moritzwerkeat/sdr-sch/74HC541D/74HC541D.stp

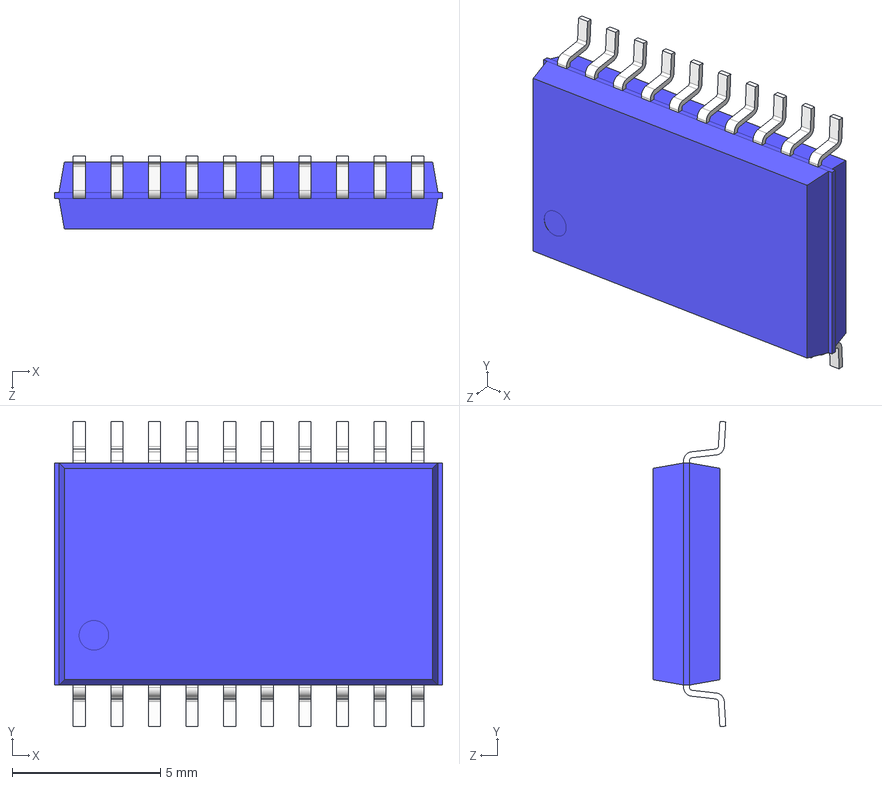
[picture p1: CAD file, 2024-10-22]
74HC541D/74HC541D.stp
13.1 x 10.3 x 2.45 mm
