moritzwerkeat/sdr-sch/74LVC04AD-Q100J/74LVC04AD-Q100J.stp

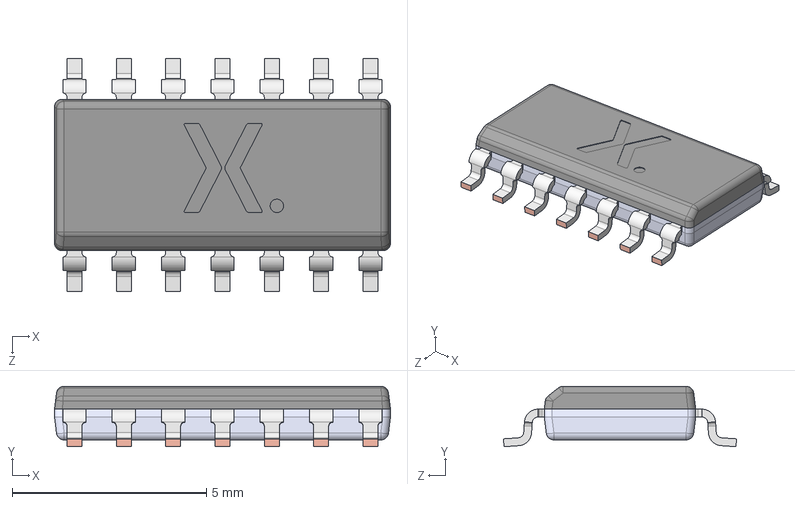
[picture p2: CAD file, 2024-10-22]
74LVC04AD-Q100J/74LVC04AD-Q100J.stp
8.65 x 1.56 x 6.00 mm
SOT108 lower body
SOT108 upper body
SOT108-1 Lead
