moritzwerkeat/sdr-sch/AP3032KTR-G1/AP3032KTR-G1.stp

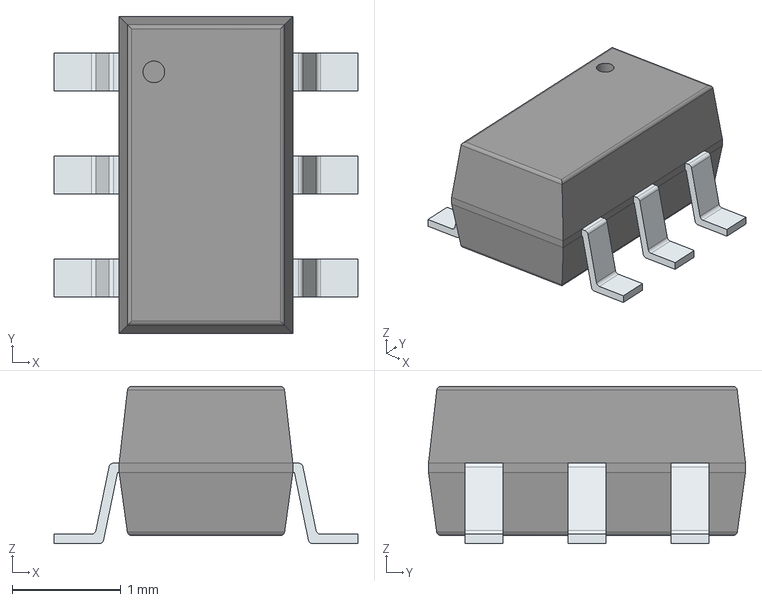
[picture p3: CAD file, 2024-10-22]
AP3032KTR-G1/AP3032KTR-G1.stp
2.80 x 2.92 x 1.45 mm
PinsArrayLR
