moritzwerkeat/sdr-sch/B5819WS/B5819WS.stp

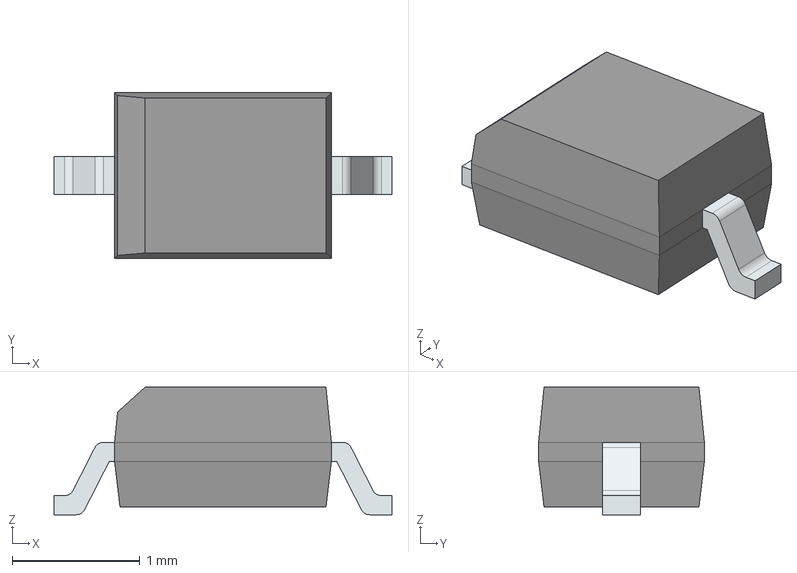
[picture p4: CAD file, 2024-10-22]
B5819WS/B5819WS.stp
2.65 x 1.30 x 1.00 mm
FilletPinL
FilletPinR
