moritzwerkeat/sdr-sch/CP2102N-A02-GQFN28/CP2102N-A02-GQFN28.stp

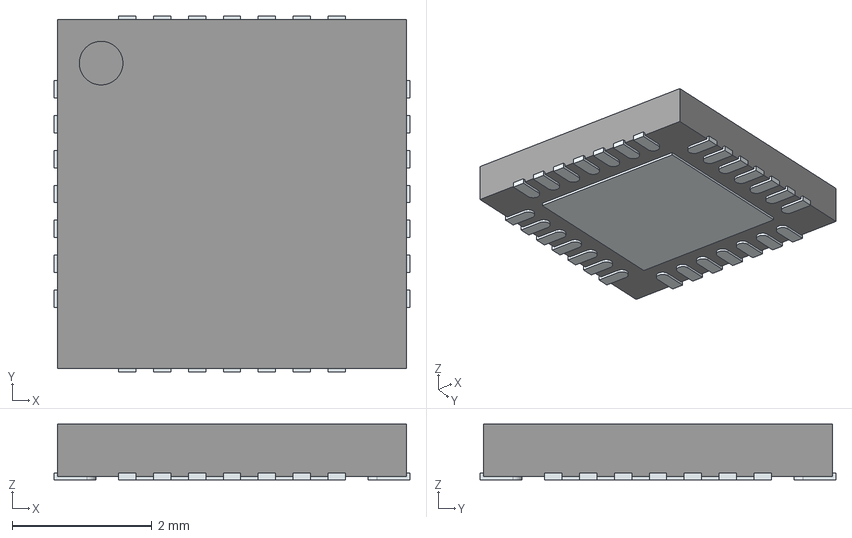
[picture p5: CAD file, 2024-10-22]
CP2102N-A02-GQFN28/CP2102N-A02-GQFN28.stp
5.10 x 5.10 x 0.8 mm
ThermalPin
PinsArrayLR
PinsArrayTB
