moritzwerkeat/sdr-sch/ESP32-S3-WROOM-2-N32R8V/ESP32-S3-WROOM-2-N32R8V.stp

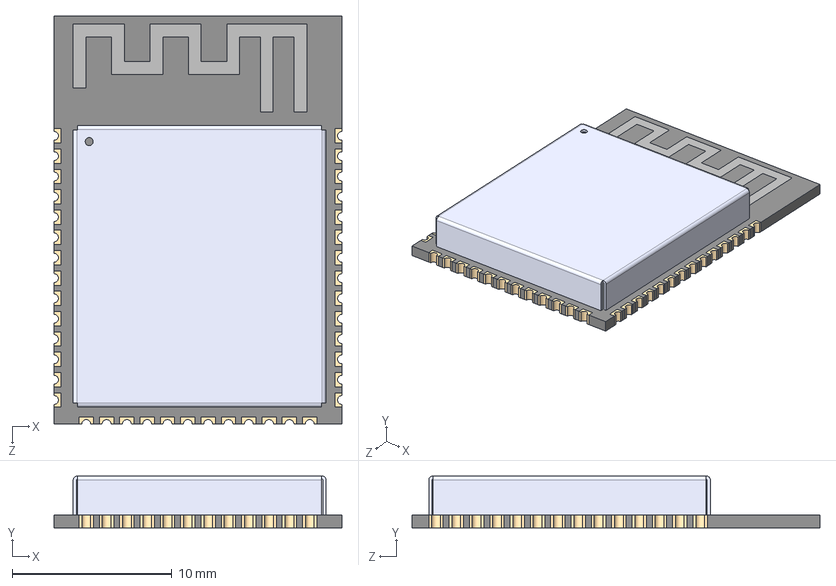
[picture p6: CAD file, 2024-10-22]
ESP32-S3-WROOM-2-N32R8V/ESP32-S3-WROOM-2-N32R8V.stp
18.0 x 3.25 x 25.5 mm
