moritzwerkeat/sdr-sch/ETA6096/ETA6096.stp

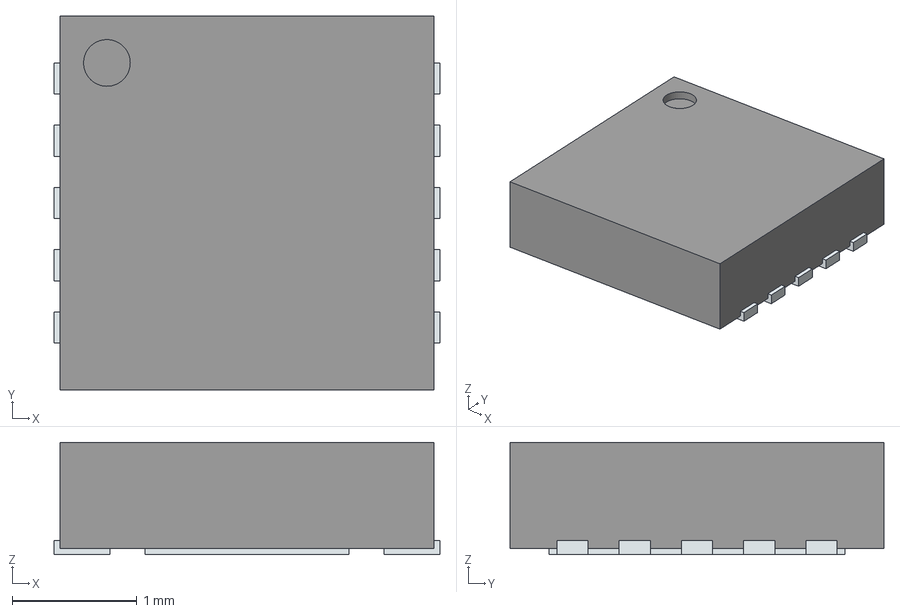
[picture p7: CAD file, 2024-10-22]
ETA6096/ETA6096.stp
3.10 x 3.00 x 0.9 mm
ThermalPin
PinsArrayLR
