moritzwerkeat/sdr-sch/F32Q-1A7H1-11050/F32Q-1A7H1-11050.stp

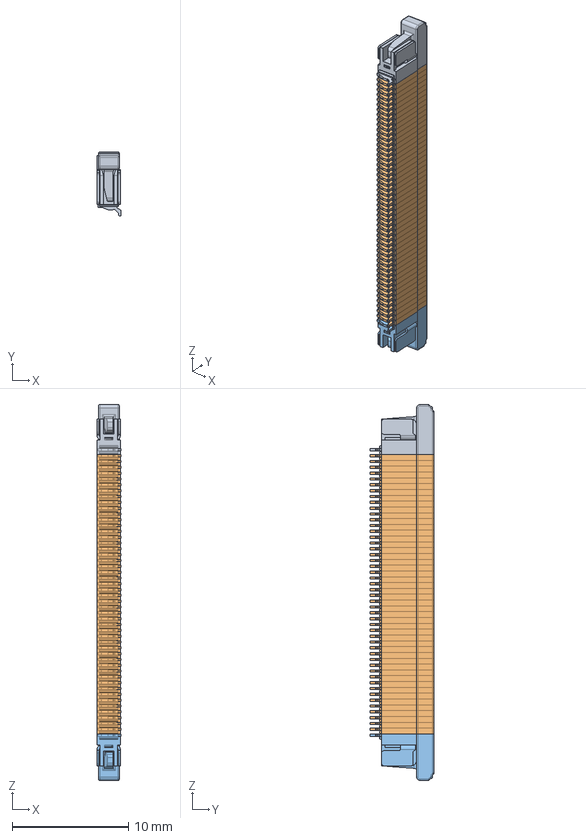
[picture p8: CAD file, 2024-10-22]
F32Q-1A7H1-11050/F32Q-1A7H1-11050.stp
2.05 x 5.50 x 32.3 mm
F32Q_L
F32Q_M x 48
F32Q_R
