moritzwerkeat/sdr-sch/L8050QLT1G/L8050QLT1G.stp

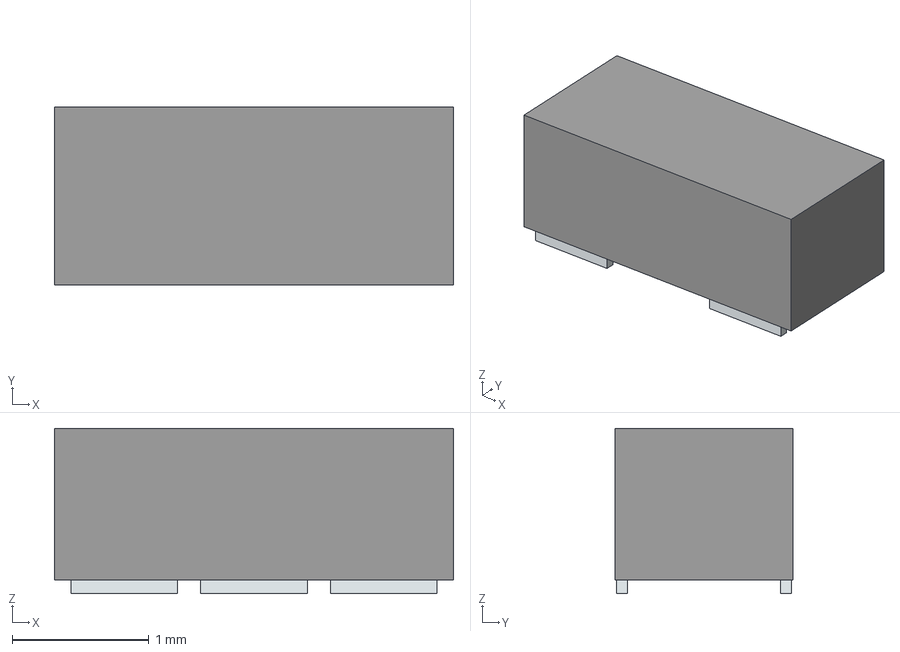
[picture p9: CAD file, 2024-10-22]
L8050QLT1G/L8050QLT1G.stp
2.92 x 1.30 x 1.21 mm
Pins
