moritzwerkeat/sdr-sch/LTRBR37G-4R4S-0125-0-2-R18/LTRBR37G-4R4S-0125-0-2-R18.stp

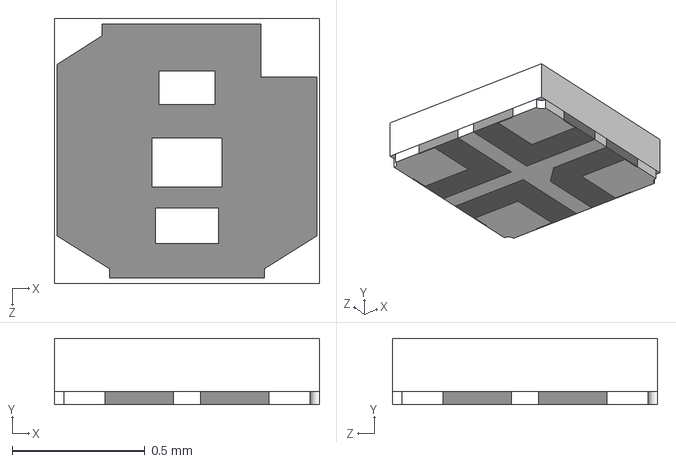
[picture p10: CAD file, 2024-10-22]
LTRBR37G-4R4S-0125-0-2-R18/LTRBR37G-4R4S-0125-0-2-R18.stp
1.00 x 0.25 x 1.00 mm
