moritzwerkeat/sdr-sch/NTC013-AT1J-A160T/NTC013-AT1J-A160T.stp

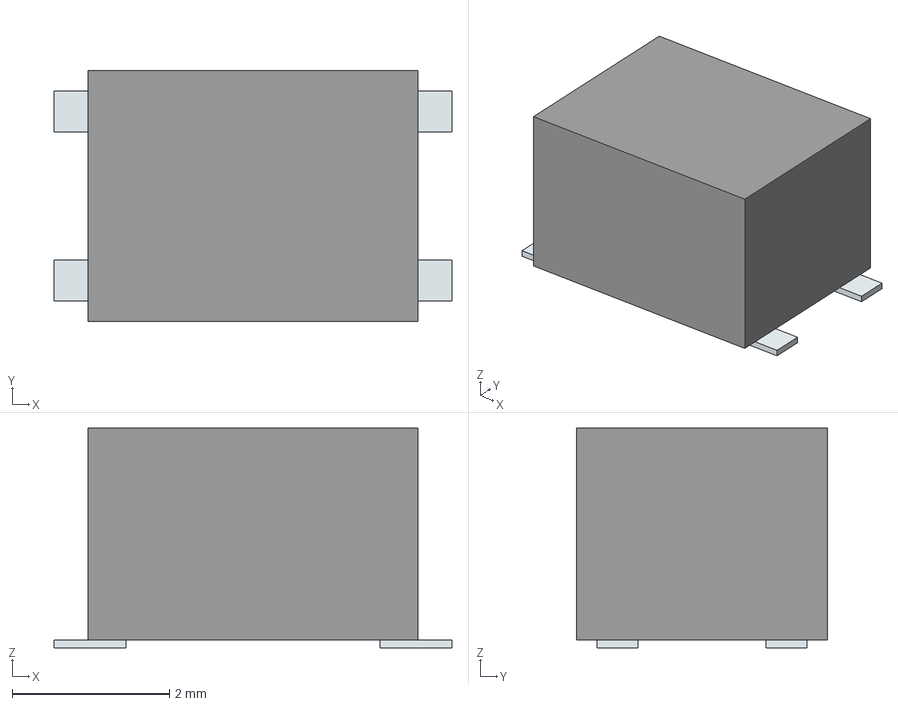
[picture p11: CAD file, 2024-10-22]
NTC013-AT1J-A160T/NTC013-AT1J-A160T.stp
5.07 x 3.20 x 2.80 mm
Pins
