moritzwerkeat/sdr-sch/PEC11S-9215F-S0015/PEC11S-9215F-S0015.stp

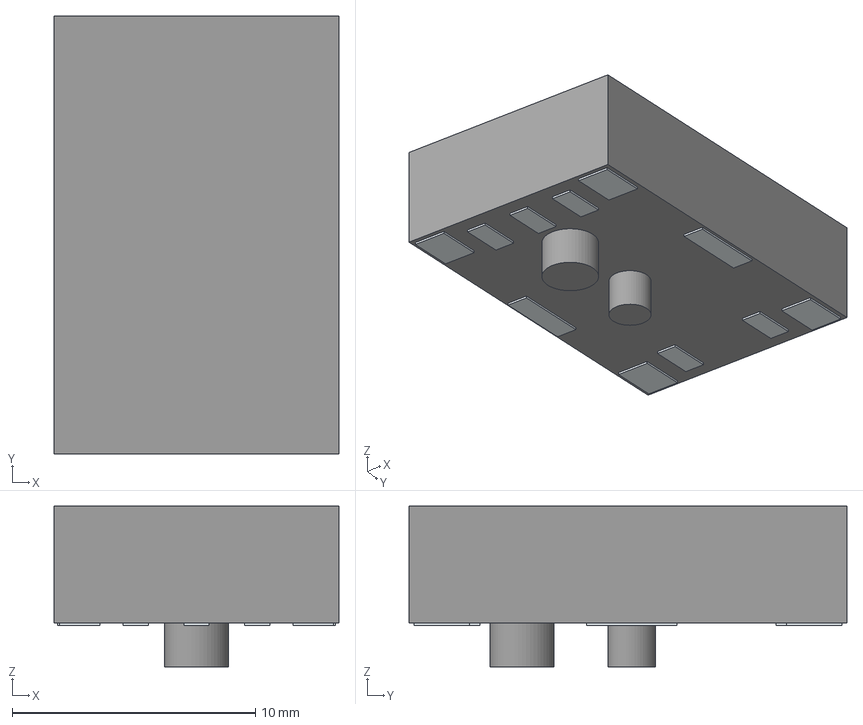
[picture p12: CAD file, 2024-10-22]
PEC11S-9215F-S0015/PEC11S-9215F-S0015.stp
11.7 x 18.0 x 6.60 mm
Pins
Lugs
