moritzwerkeat/sdr-sch/S8050G/S8050G.stp

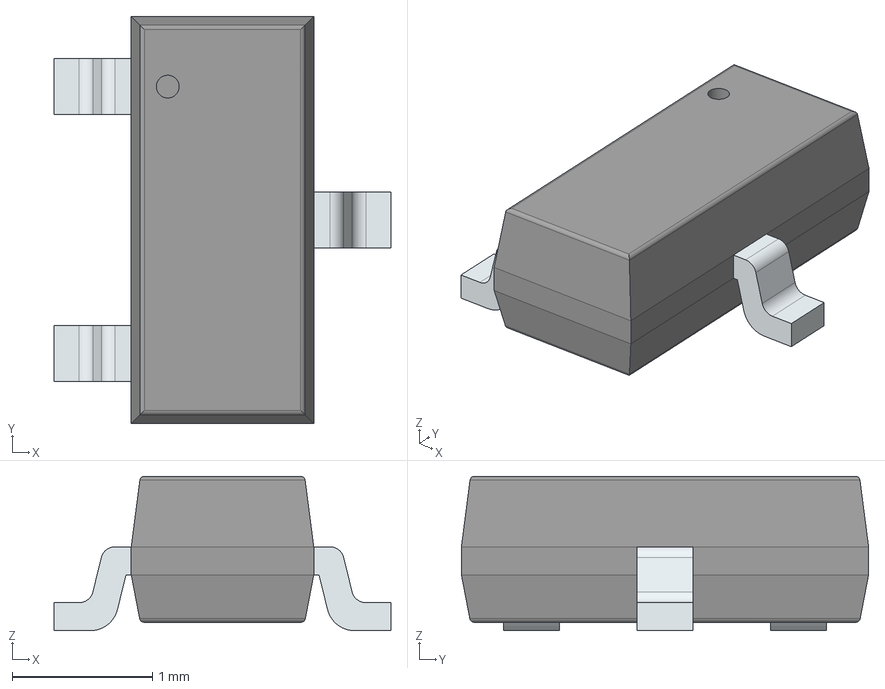
[picture p13: CAD file, 2024-10-22]
S8050G/S8050G.stp
2.40 x 2.90 x 1.10 mm
PinsArrayL
FilletPinR
