moritzwerkeat/sdr-sch/SN74LS30D/SN74LS30D.stp

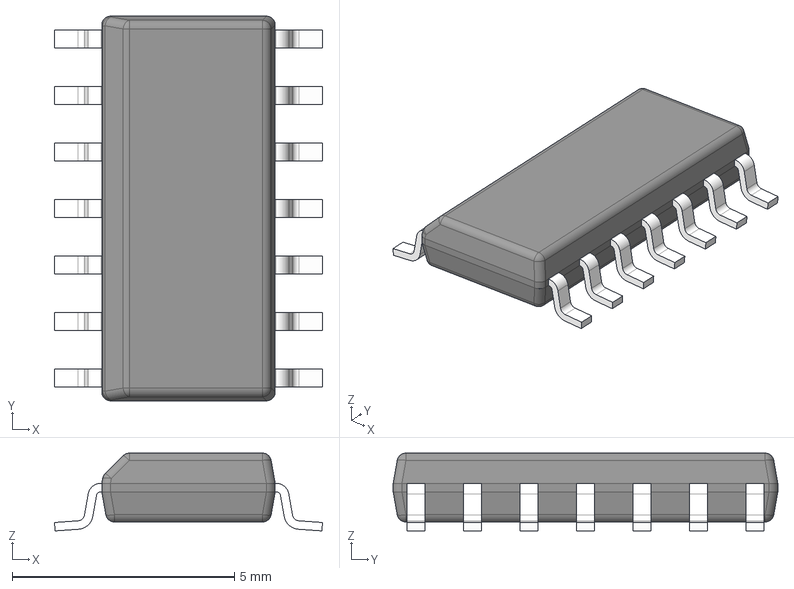
[picture p14: CAD file, 2024-10-22]
SN74LS30D/SN74LS30D.stp
6.03 x 8.65 x 1.75 mm
BODY-SO
LEAD-SO x 14
PIN1-ID
