moritzwerkeat/sdr-sch/TCA6416APWR/TCA6416APWR.stp

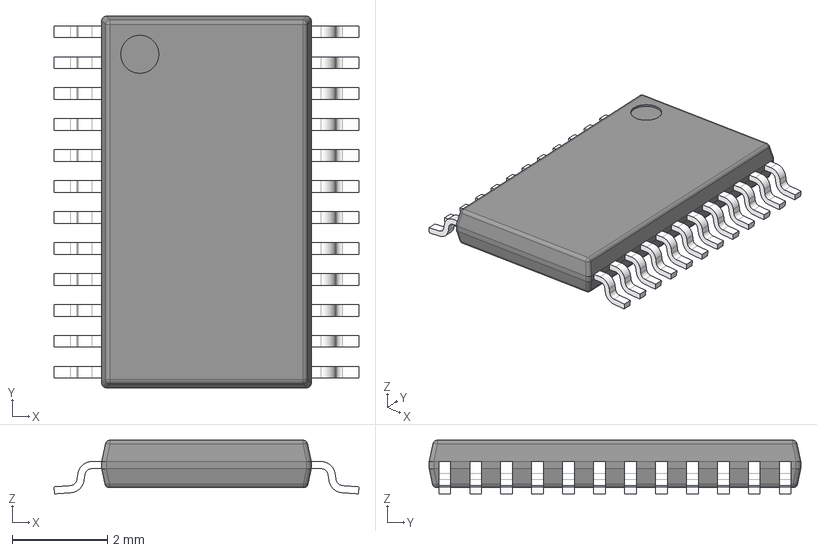
[picture p15: CAD file, 2024-10-22]
TCA6416APWR/TCA6416APWR.stp
6.40 x 7.80 x 1.13 mm
BODY-TSSOP
LEAD-TSSOP x 24
PIN1
