moritzwerkeat/sdr-sch/TCA9554PWR/TCA9554PWR.stp

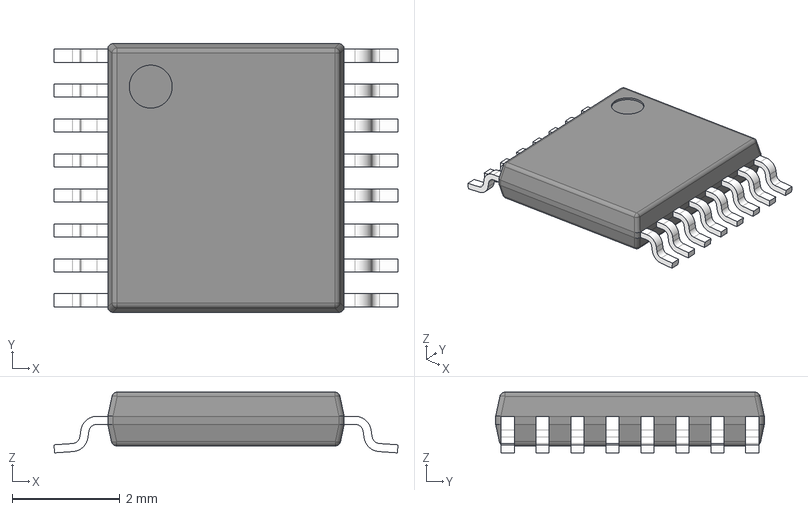
[picture p16: CAD file, 2024-10-22]
TCA9554PWR/TCA9554PWR.stp
6.40 x 5.00 x 1.13 mm
BODY-TSSOP
LEAD-TSSOP x 16
PIN1
