moritzwerkeat/sdr-sch/USB4110-GF-A/USB4110-GF-A.stp

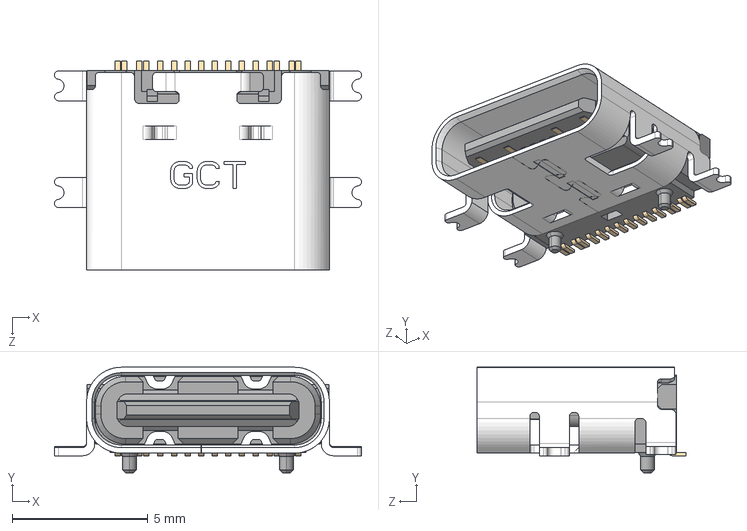
[picture p17: CAD file, 2024-10-22]
USB4110-GF-A/USB4110-GF-A.stp
11.3 x 3.89 x 7.70 mm
