moritzwerkeat/sdr-sch/USB4145-03-0230-C/USB4145-03-0230-C.stp

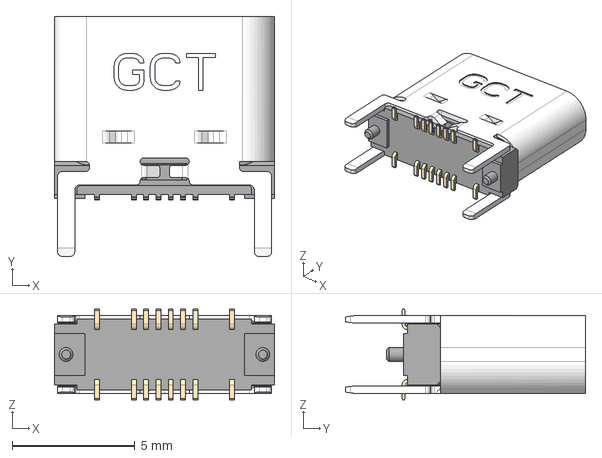
[picture p18: CAD file, 2024-10-22]
USB4145-03-0230-C/USB4145-03-0230-C.stp
8.95 x 9.76 x 3.69 mm
USB4145-03-0230-C_PART2
USB4145-03-0230-C_PART1
