moritzwerkeat/sdr-sch/(list of files, cad)

Other CAD files:
53047-0210/53047-0210.stp
AP63203WU-7/AP63203WU-7.stp
