moritzwerkeat/sdr-sch/sdr.kicad_pcb

## KiCad design sdr.kicad_pcb (2024-10-22)

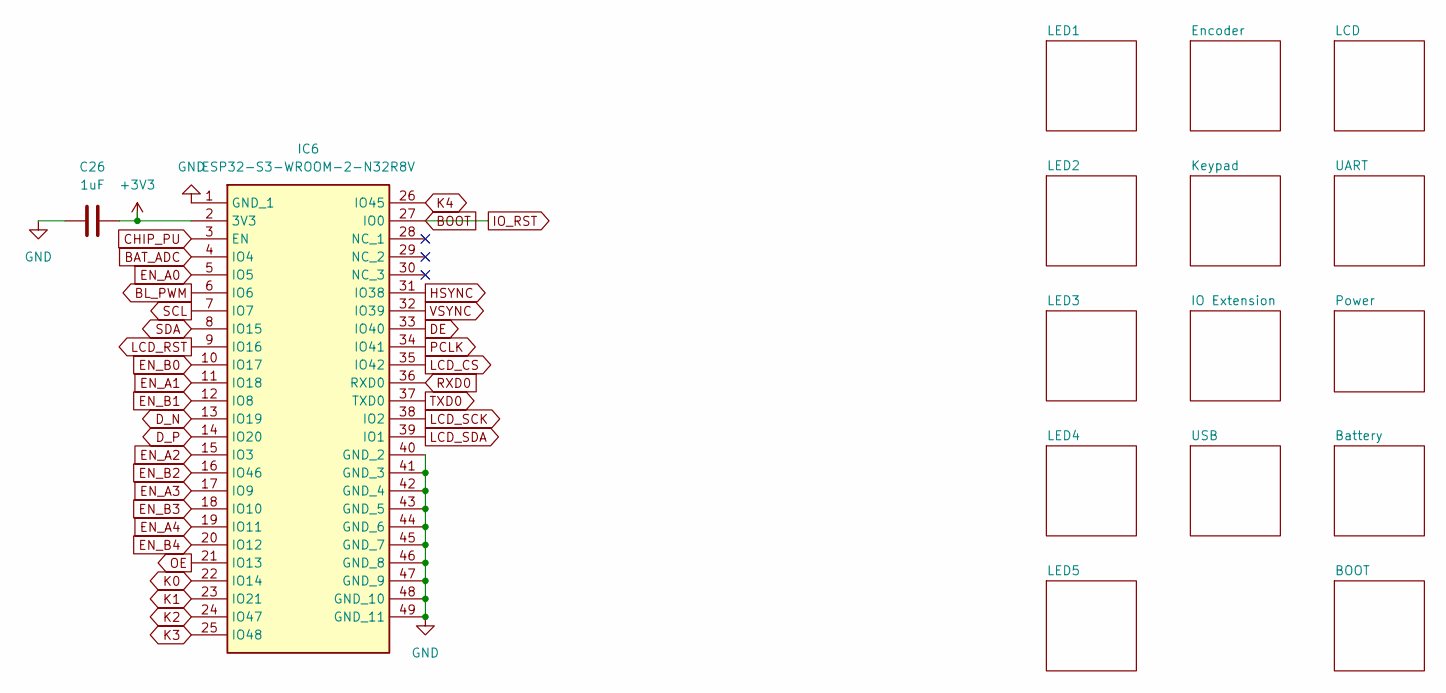
[picture p19: schematic sdr.kicad_sch]

Parts:
C26: 1uF; C_0603_1608Metric
IC6: ESP32-S3-WROOM-2-N32R8V; ESP32S3WROOM2N32R8V; Manufacturer_Part_Number ESP32-S3-WROOM-2-N32R8V; Mouser Part Number 356-ESP3S3WRM2N32R8V

Connections:
+3V3: C26.1, IC6.2 (3V3); also elsewhere on the board
BAT_ADC: IC6.4 (IO4); also elsewhere on the board
BL_PWM: IC6.6 (IO6); also elsewhere on the board
BOOT: IC6.27 (IO0); also elsewhere on the board
CHIP_PU: IC6.3 (EN); also elsewhere on the board
DE: IC6.33 (IO40); also elsewhere on the board
D_N: IC6.13 (IO19); also elsewhere on the board
D_P: IC6.14 (IO20); also elsewhere on the board
EN_A0: IC6.5 (IO5); also elsewhere on the board
EN_A1: IC6.11 (IO18); also elsewhere on the board
EN_A2: IC6.15 (IO3); also elsewhere on the board
EN_A3: IC6.17 (IO9); also elsewhere on the board
EN_A4: IC6.19 (IO11); also elsewhere on the board
EN_B0: IC6.10 (IO17); also elsewhere on the board
EN_B1: IC6.12 (IO8); also elsewhere on the board
EN_B2: IC6.16 (IO46); also elsewhere on the board
EN_B3: IC6.18 (IO10); also elsewhere on the board
EN_B4: IC6.20 (IO12); also elsewhere on the board
GND: C26.2, IC6.1 (GND_1), IC6.40 (GND_2), IC6.41 (GND_3), IC6.42 (GND_4), IC6.43 (GND_5), IC6.44 (GND_6), IC6.45 (GND_7), IC6.46 (GND_8), IC6.47 (GND_9), IC6.48 (GND_10), IC6.49 (GND_11); also elsewhere on the board
HSYNC: IC6.31 (IO38); also elsewhere on the board
K0: IC6.22 (IO14); also elsewhere on the board
K1: IC6.23 (IO21); also elsewhere on the board
K2: IC6.24 (IO47); also elsewhere on the board
K3: IC6.25 (IO48); also elsewhere on the board
K4: IC6.26 (IO45); also elsewhere on the board
LCD_CS: IC6.35 (IO42); also elsewhere on the board
LCD_RST: IC6.9 (IO16); also elsewhere on the board
LCD_SCK: IC6.38 (IO2); also elsewhere on the board
LCD_SDA: IC6.39 (IO1); also elsewhere on the board
OE: IC6.21 (IO13); also elsewhere on the board
PCLK: IC6.34 (IO41); also elsewhere on the board
RXD0: IC6.36 (RXD0); also elsewhere on the board
SCL: IC6.7 (IO7); also elsewhere on the board
SDA: IC6.8 (IO15); also elsewhere on the board
TXD0: IC6.37 (TXD0); also elsewhere on the board
VSYNC: IC6.32 (IO39); also elsewhere on the board

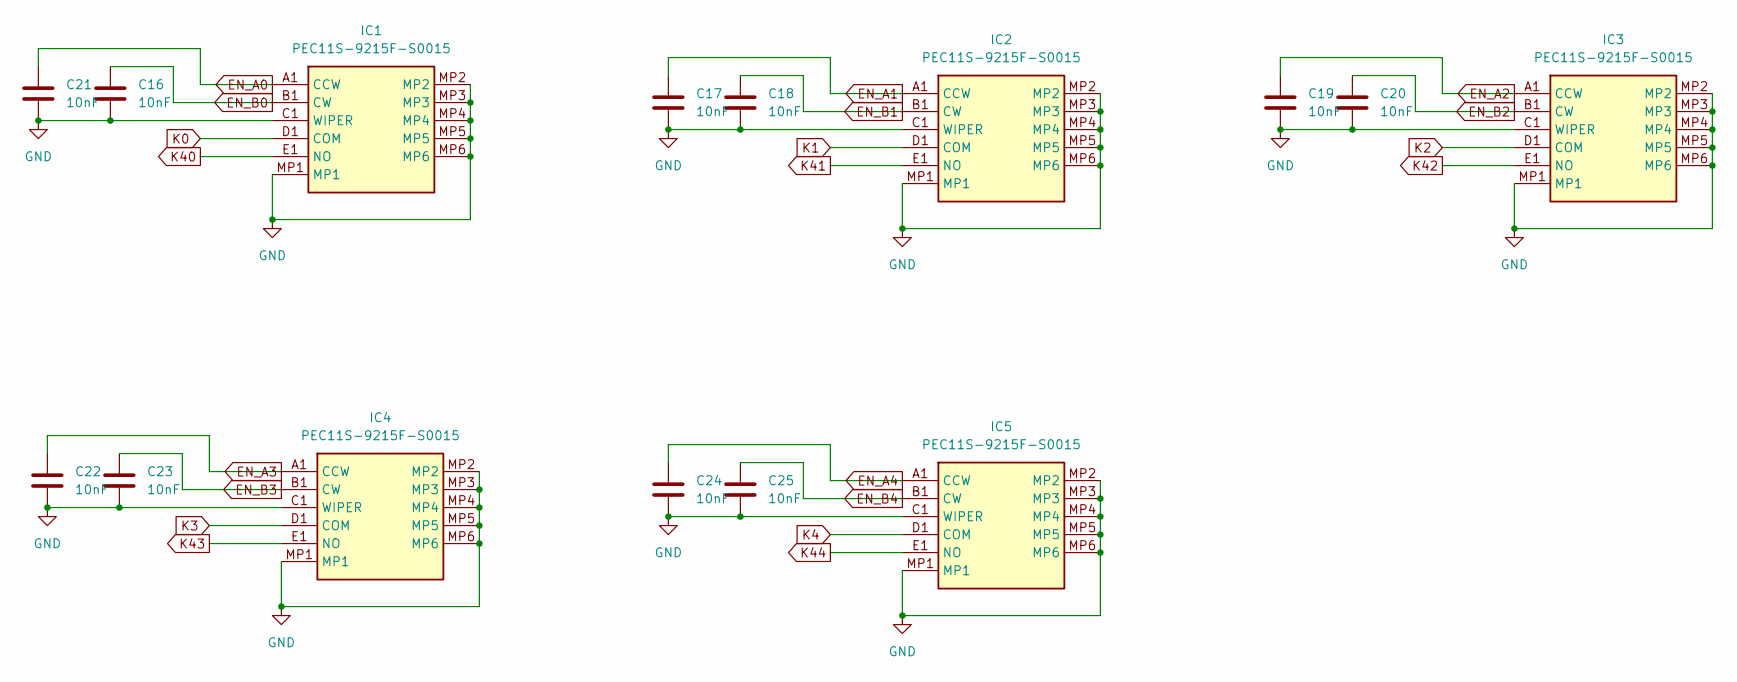
[picture p20: schematic encoder.kicad_sch]

Parts:
C16, C17, C18, C19, C20, C21, C22, C23, C24, C25: 10nF; C_0603_1608Metric
IC1, IC2, IC3, IC4, IC5: PEC11S-9215F-S0015; PEC11S9215FS0015; Manufacturer_Part_Number PEC11S-9215F-S0015; Mouser Part Number 652-PEC11S9215FS0015

Connections:
EN_A0: C21.1, IC1.A1 (CCW); also elsewhere on the board
EN_A1: C17.1, IC2.A1 (CCW); also elsewhere on the board
EN_A2: C19.1, IC3.A1 (CCW); also elsewhere on the board
EN_A3: C22.1, IC4.A1 (CCW); also elsewhere on the board
EN_A4: C24.1, IC5.A1 (CCW); also elsewhere on the board
EN_B0: C16.1, IC1.B1 (CW); also elsewhere on the board
EN_B1: C18.1, IC2.B1 (CW); also elsewhere on the board
EN_B2: C20.1, IC3.B1 (CW); also elsewhere on the board
EN_B3: C23.1, IC4.B1 (CW); also elsewhere on the board
EN_B4: C25.1, IC5.B1 (CW); also elsewhere on the board
GND: C16.2, C17.2, C18.2, C19.2, C20.2, C21.2, C22.2, C23.2, C24.2, C25.2, IC1.C1 (WIPER), IC1.MP1, IC1.MP2, IC1.MP3, IC1.MP4, IC1.MP5, IC1.MP6, IC2.C1 (WIPER), IC2.MP1, IC2.MP2, IC2.MP3, IC2.MP4, IC2.MP5, IC2.MP6, IC3.C1 (WIPER), IC3.MP1, IC3.MP2, IC3.MP3, IC3.MP4, IC3.MP5, IC3.MP6, IC4.C1 (WIPER), IC4.MP1, IC4.MP2, IC4.MP3, IC4.MP4, IC4.MP5, IC4.MP6, IC5.C1 (WIPER), IC5.MP1, IC5.MP2, IC5.MP3, IC5.MP4, IC5.MP5, IC5.MP6; also elsewhere on the board
K0: IC1.D1 (COM); also elsewhere on the board
K1: IC2.D1 (COM); also elsewhere on the board
K2: IC3.D1 (COM); also elsewhere on the board
K3: IC4.D1 (COM); also elsewhere on the board
K4: IC5.D1 (COM); also elsewhere on the board
K40: IC1.E1 (NO); also elsewhere on the board
K41: IC2.E1 (NO); also elsewhere on the board
K42: IC3.E1 (NO); also elsewhere on the board
K43: IC4.E1 (NO); also elsewhere on the board
K44: IC5.E1 (NO); also elsewhere on the board

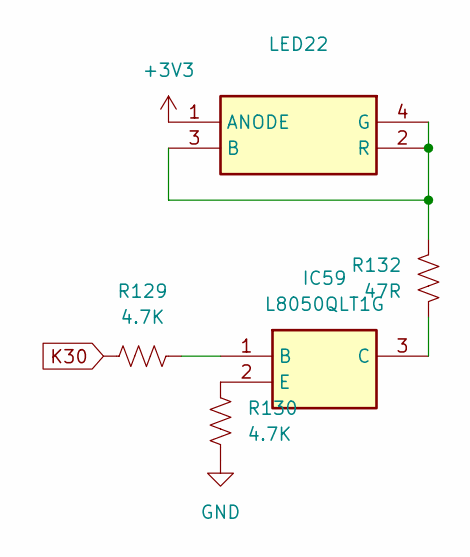
[picture p21: schematic led4.kicad_sch]

Parts:
IC59: L8050QLT1G; Manufacturer_Part_Number L8050QLT1G
LED22: LTRBR37G-4R4S-0125-0-2-R18; LTRBR37G4R4S012502R18; Manufacturer_Part_Number LTRBR37G-4R4S-0125-0-2-R18; Mouser Part Number 720-LTRBR37GA6714
R129, R130: 4.7K; R_0603_1608Metric
R132: 47R; R_0603_1608Metric

Connections:
+3V3: LED22.1 (ANODE); also elsewhere on the board
GND: R130.1; also elsewhere on the board
unnamed: IC59.1 (B), R129.2
unnamed: IC59.3 (C), R132.1
unnamed: IC59.2 (E), R130.2
unnamed: LED22.2 (R), LED22.3 (B), LED22.4 (G), R132.2

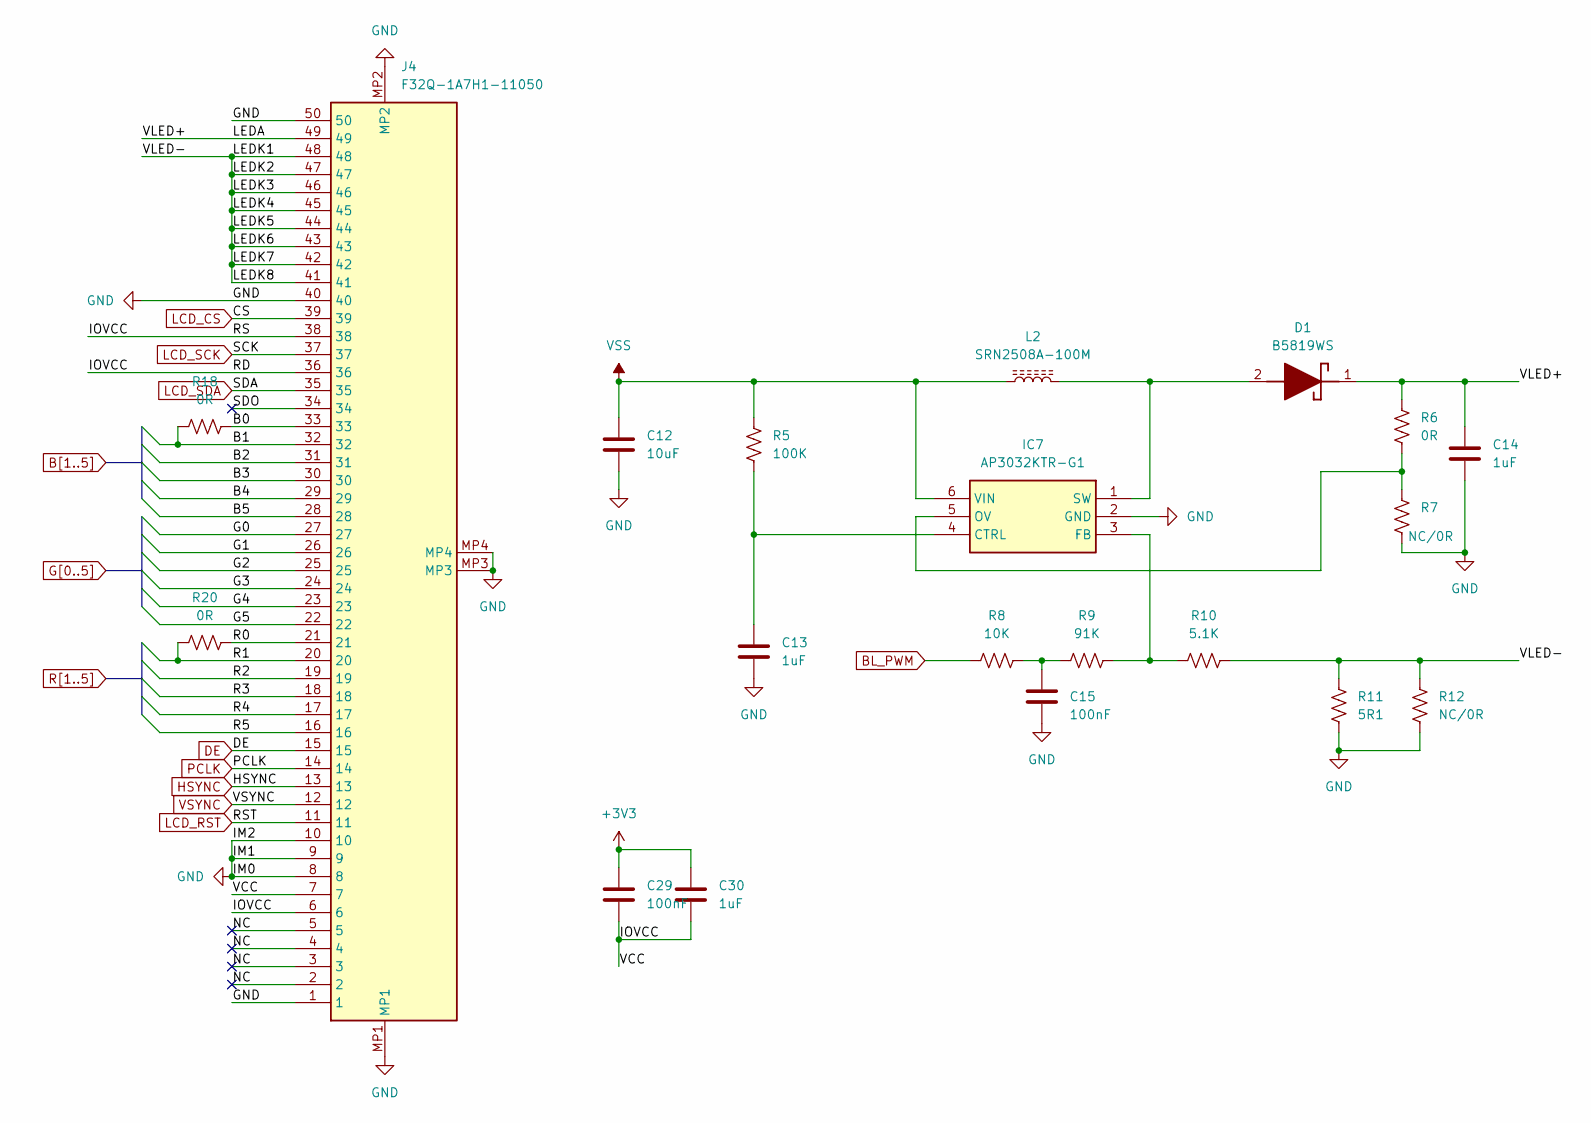
[picture p22: schematic lcd.kicad_sch]

Parts:
C12: 10uF; C_0603_1608Metric
C13, C14, C30: 1uF; C_0603_1608Metric
C15, C29: 100nF; C_0603_1608Metric
D1: B5819WS; SOD2613X100N; Manufacturer_Part_Number B5819WS
IC7: AP3032KTR-G1; SOT95P280X145-6N; Manufacturer_Part_Number AP3032KTR-G1; Mouser Part Number 621-AP3032KTR-G1
J4: F32Q-1A7H1-11050; F32Q1A7H111050; Manufacturer_Part_Number F32Q-1A7H1-11050; Mouser Part Number 649-F32Q-1A7H1-11050
L2: SRN2508A-100M; L_1008_2520Metric
R5: 100K; R_0603_1608Metric
R6, R18, R20: 0R; R_0603_1608Metric
R7, R12: NC/0R; R_0603_1608Metric
R8: 10K; R_0603_1608Metric
R9: 91K; R_0603_1608Metric
R10: 5.1K; R_0603_1608Metric
R11: 5R1; R_0603_1608Metric

Connections:
+3V3: C29.1, C30.1; also elsewhere on the board
/LCD/B0: J4.33, R18.2
/LCD/IOVCC: C29.2, C30.2, J4.6, J4.7, J4.36, J4.38
/LCD/LEDA: C14.1, D1.1 (K), J4.49, R6.1
/LCD/LEDK1: J4.41, J4.42, J4.43, J4.44, J4.45, J4.46, J4.47, J4.48, R10.2, R11.2, R12.2
/LCD/NC: J4.2, J4.3, J4.4, J4.5
/LCD/R0: J4.21, R20.2
/LCD/SDO: J4.34
B1: J4.32, R18.1; also elsewhere on the board
B2: J4.31; also elsewhere on the board
B3: J4.30; also elsewhere on the board
B4: J4.29; also elsewhere on the board
B5: J4.28; also elsewhere on the board
BL_PWM: R8.1; also elsewhere on the board
DE: J4.15; also elsewhere on the board
G0: J4.27; also elsewhere on the board
G1: J4.26; also elsewhere on the board
G2: J4.25; also elsewhere on the board
G3: J4.24; also elsewhere on the board
G4: J4.23; also elsewhere on the board
G5: J4.22; also elsewhere on the board
GND: C12.2, C13.2, C14.2, C15.2, IC7.2 (GND), J4.1, J4.8, J4.9, J4.10, J4.40, J4.50, J4.MP1, J4.MP2, J4.MP3, J4.MP4, R7.2, R11.1, R12.1; also elsewhere on the board
HSYNC: J4.13; also elsewhere on the board
LCD_CS: J4.39; also elsewhere on the board
LCD_RST: J4.11; also elsewhere on the board
LCD_SCK: J4.37; also elsewhere on the board
LCD_SDA: J4.35; also elsewhere on the board
unnamed: C15.1, R8.2, R9.1
unnamed: D1.2 (A), IC7.1 (SW), L2.2
unnamed: C13.1, IC7.4 (CTRL), R5.2
unnamed: IC7.3 (FB), R9.2, R10.1
unnamed: IC7.5 (OV), R6.2, R7.1
PCLK: J4.14; also elsewhere on the board
R1: J4.20, R20.1; also elsewhere on the board
R2: J4.19; also elsewhere on the board
R3: J4.18; also elsewhere on the board
R4: J4.17; also elsewhere on the board
R5: J4.16; also elsewhere on the board
VSS: C12.1, IC7.6 (VIN), L2.1, R5.1; also elsewhere on the board
VSYNC: J4.12; also elsewhere on the board

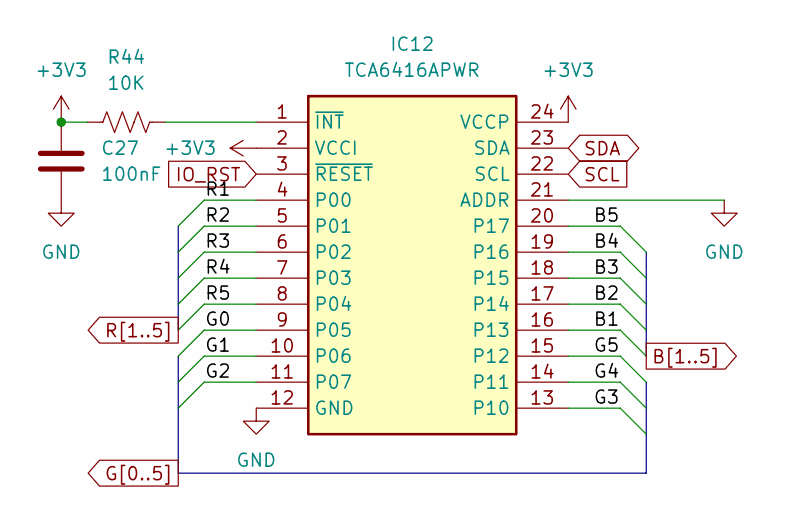
[picture p23: schematic io.kicad_sch]

Parts:
C27: 100nF; C_0603_1608Metric
IC12: TCA6416APWR; SOP65P640X120-24N; Manufacturer_Part_Number TCA6416APWR; Mouser Part Number 595-TCA6416APWR
R44: 10K; R_0603_1608Metric

Connections:
+3V3: C27.1, IC12.2 (VCCI), IC12.24 (VCCP), R44.1; also elsewhere on the board
B1: IC12.16 (P13); also elsewhere on the board
B2: IC12.17 (P14); also elsewhere on the board
B3: IC12.18 (P15); also elsewhere on the board
B4: IC12.19 (P16); also elsewhere on the board
B5: IC12.20 (P17); also elsewhere on the board
BOOT: IC12.3 (~RESET); also elsewhere on the board
G0: IC12.9 (P05); also elsewhere on the board
G1: IC12.10 (P06); also elsewhere on the board
G2: IC12.11 (P07); also elsewhere on the board
G3: IC12.13 (P10); also elsewhere on the board
G4: IC12.14 (P11); also elsewhere on the board
G5: IC12.15 (P12); also elsewhere on the board
GND: C27.2, IC12.12 (GND), IC12.21 (ADDR); also elsewhere on the board
unnamed: IC12.1 (~INT), R44.2
R1: IC12.4 (P00); also elsewhere on the board
R2: IC12.5 (P01); also elsewhere on the board
R3: IC12.6 (P02); also elsewhere on the board
R4: IC12.7 (P03); also elsewhere on the board
R5: IC12.8 (P04); also elsewhere on the board
SCL: IC12.22 (SCL); also elsewhere on the board
SDA: IC12.23 (SDA); also elsewhere on the board

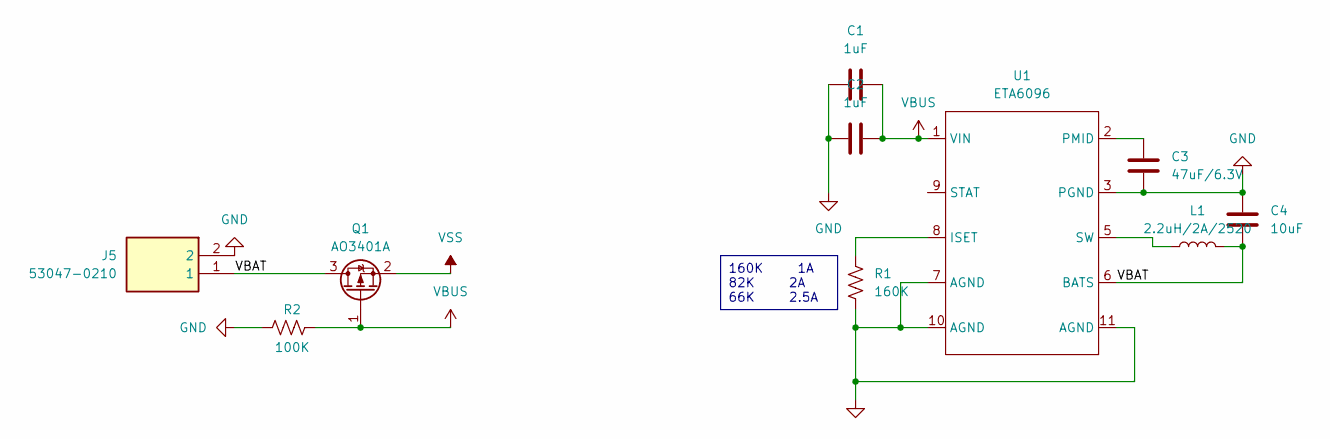
[picture p24: schematic battery.kicad_sch]

Parts:
C1, C2: 1uF; C_0603_1608Metric
C3: 47uF/6.3V; C_0603_1608Metric
C4: 10uF; C_0603_1608Metric
J5: 53047-0210; 530470210; Manufacturer_Part_Number 53047-0210; Mouser Part Number 538-53047-0210
L1: 2.2uH/2A/2520; L_1008_2520Metric
Q1: AO3401A; SOT-23
R1: 160K; R_0603_1608Metric
R2: 100K; R_0603_1608Metric
U1: ETA6096; SON50P300X300X90-11N

Connections:
/Battery/VBAT: C4.2, J5.1, L1.2, Q1.3 (D), U1.6 (BATS)
GND: C1.2, C2.2, C3.2, C4.1, J5.2, R1.1, R2.1, U1.3 (PGND), U1.7 (AGND), U1.10 (AGND), U1.11 (AGND); also elsewhere on the board
unnamed: R1.2, U1.8 (ISET)
unnamed: C3.1, U1.2 (PMID)
unnamed: L1.1, U1.5 (SW)
VBUS: C1.1, C2.1, Q1.1 (G), R2.2, U1.1 (VIN); also elsewhere on the board
VSS: Q1.2 (S); also elsewhere on the board

Notes on the sheet:
160K 1A 82K 2A 66K 2.5A

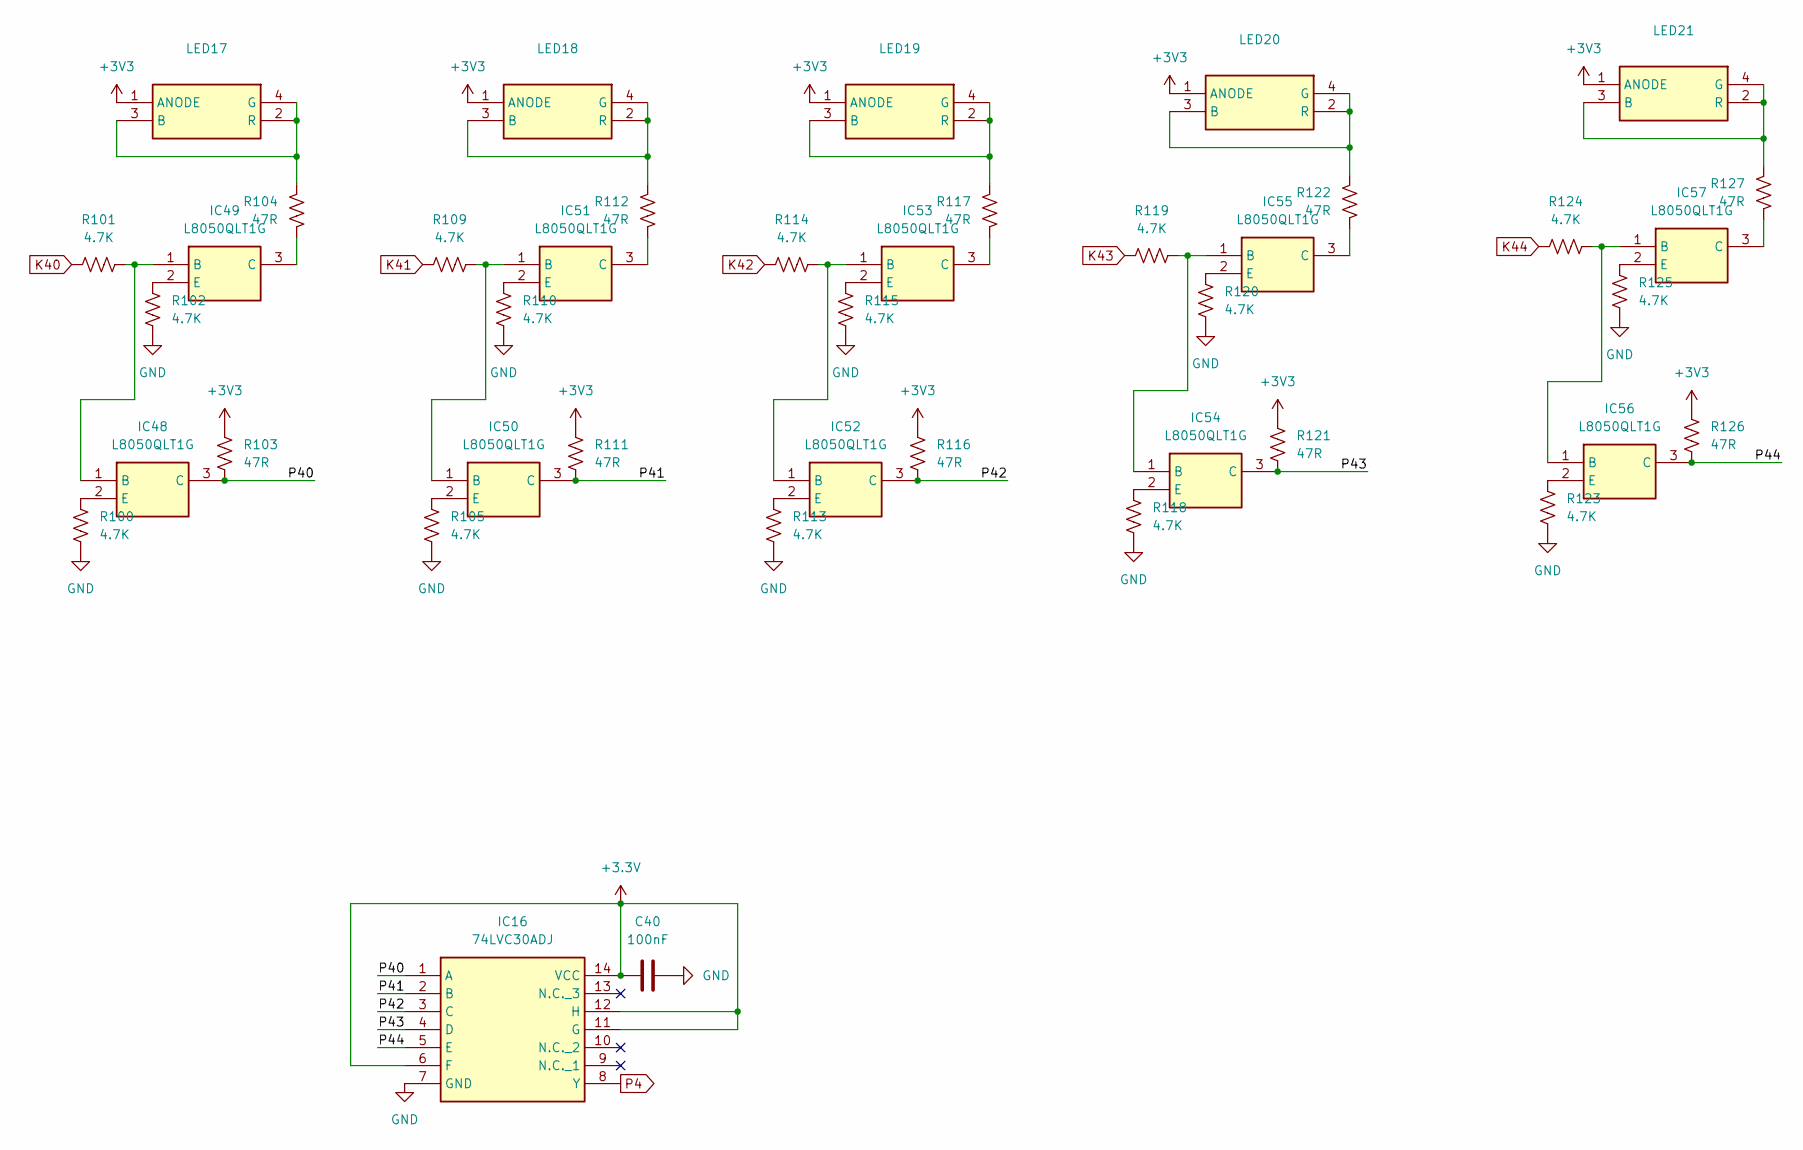
[picture p25: schematic led5.kicad_sch]

Parts:
C40: 100nF; C_0603_1608Metric
IC16: 74LVC30ADJ; SOIC127P600X175-14N; Manufacturer_Part_Number 74LVC30ADJ; Mouser Part Number 771-74LVC30ADJ
IC48, IC49, IC50, IC51, IC52, IC53, IC54, IC55, IC56, IC57: L8050QLT1G; Manufacturer_Part_Number L8050QLT1G
LED17, LED18, LED19, LED20, LED21: LTRBR37G-4R4S-0125-0-2-R18; LTRBR37G4R4S012502R18; Manufacturer_Part_Number LTRBR37G-4R4S-0125-0-2-R18; Mouser Part Number 720-LTRBR37GA6714
R100, R101, R102, R105, R109, R110, R113, R114, R115, R118, R119, R120, R123, R124, R125: 4.7K; R_0603_1608Metric
R103, R104, R111, R112, R116, R117, R121, R122, R126, R127: 47R; R_0603_1608Metric

Connections:
+3.3V: C40.1, IC16.6 (F), IC16.11 (G), IC16.12 (H), IC16.14 (VCC); also elsewhere on the board
+3V3: LED17.1 (ANODE), LED18.1 (ANODE), LED19.1 (ANODE), LED20.1 (ANODE), LED21.1 (ANODE), R103.2, R111.2, R116.2, R121.2, R126.2; also elsewhere on the board
/LED5/P40: IC16.1 (A), IC48.3 (C), R103.1
/LED5/P41: IC16.2 (B), IC50.3 (C), R111.1
/LED5/P42: IC16.3 (C), IC52.3 (C), R116.1
/LED5/P43: IC16.4 (D), IC54.3 (C), R121.1
/LED5/P44: IC16.5 (E), IC56.3 (C), R126.1
GND: C40.2, IC16.7 (GND), R100.1, R102.1, R105.1, R110.1, R113.1, R115.1, R118.1, R120.1, R123.1, R125.1; also elsewhere on the board
K40: R101.1; also elsewhere on the board
K41: R109.1; also elsewhere on the board
K42: R114.1; also elsewhere on the board
K43: R119.1; also elsewhere on the board
K44: R124.1; also elsewhere on the board
unnamed: IC48.1 (B), IC49.1 (B), R101.2
unnamed: IC48.2 (E), R100.2
unnamed: IC49.3 (C), R104.1
unnamed: IC49.2 (E), R102.2
unnamed: IC50.1 (B), IC51.1 (B), R109.2
unnamed: IC50.2 (E), R105.2
unnamed: IC51.3 (C), R112.1
unnamed: IC51.2 (E), R110.2
unnamed: IC52.1 (B), IC53.1 (B), R114.2
unnamed: IC52.2 (E), R113.2
unnamed: IC53.3 (C), R117.1
unnamed: IC53.2 (E), R115.2
unnamed: IC54.1 (B), IC55.1 (B), R119.2
unnamed: IC54.2 (E), R118.2
unnamed: IC55.3 (C), R122.1
unnamed: IC55.2 (E), R120.2
unnamed: IC56.1 (B), IC57.1 (B), R124.2
unnamed: IC56.2 (E), R123.2
unnamed: IC57.3 (C), R127.1
unnamed: IC57.2 (E), R125.2
unnamed: LED17.2 (R), LED17.3 (B), LED17.4 (G), R104.2
unnamed: LED18.2 (R), LED18.3 (B), LED18.4 (G), R112.2
unnamed: LED19.2 (R), LED19.3 (B), LED19.4 (G), R117.2
unnamed: LED20.2 (R), LED20.3 (B), LED20.4 (G), R122.2
unnamed: LED21.2 (R), LED21.3 (B), LED21.4 (G), R127.2
P4: IC16.8 (Y); also elsewhere on the board

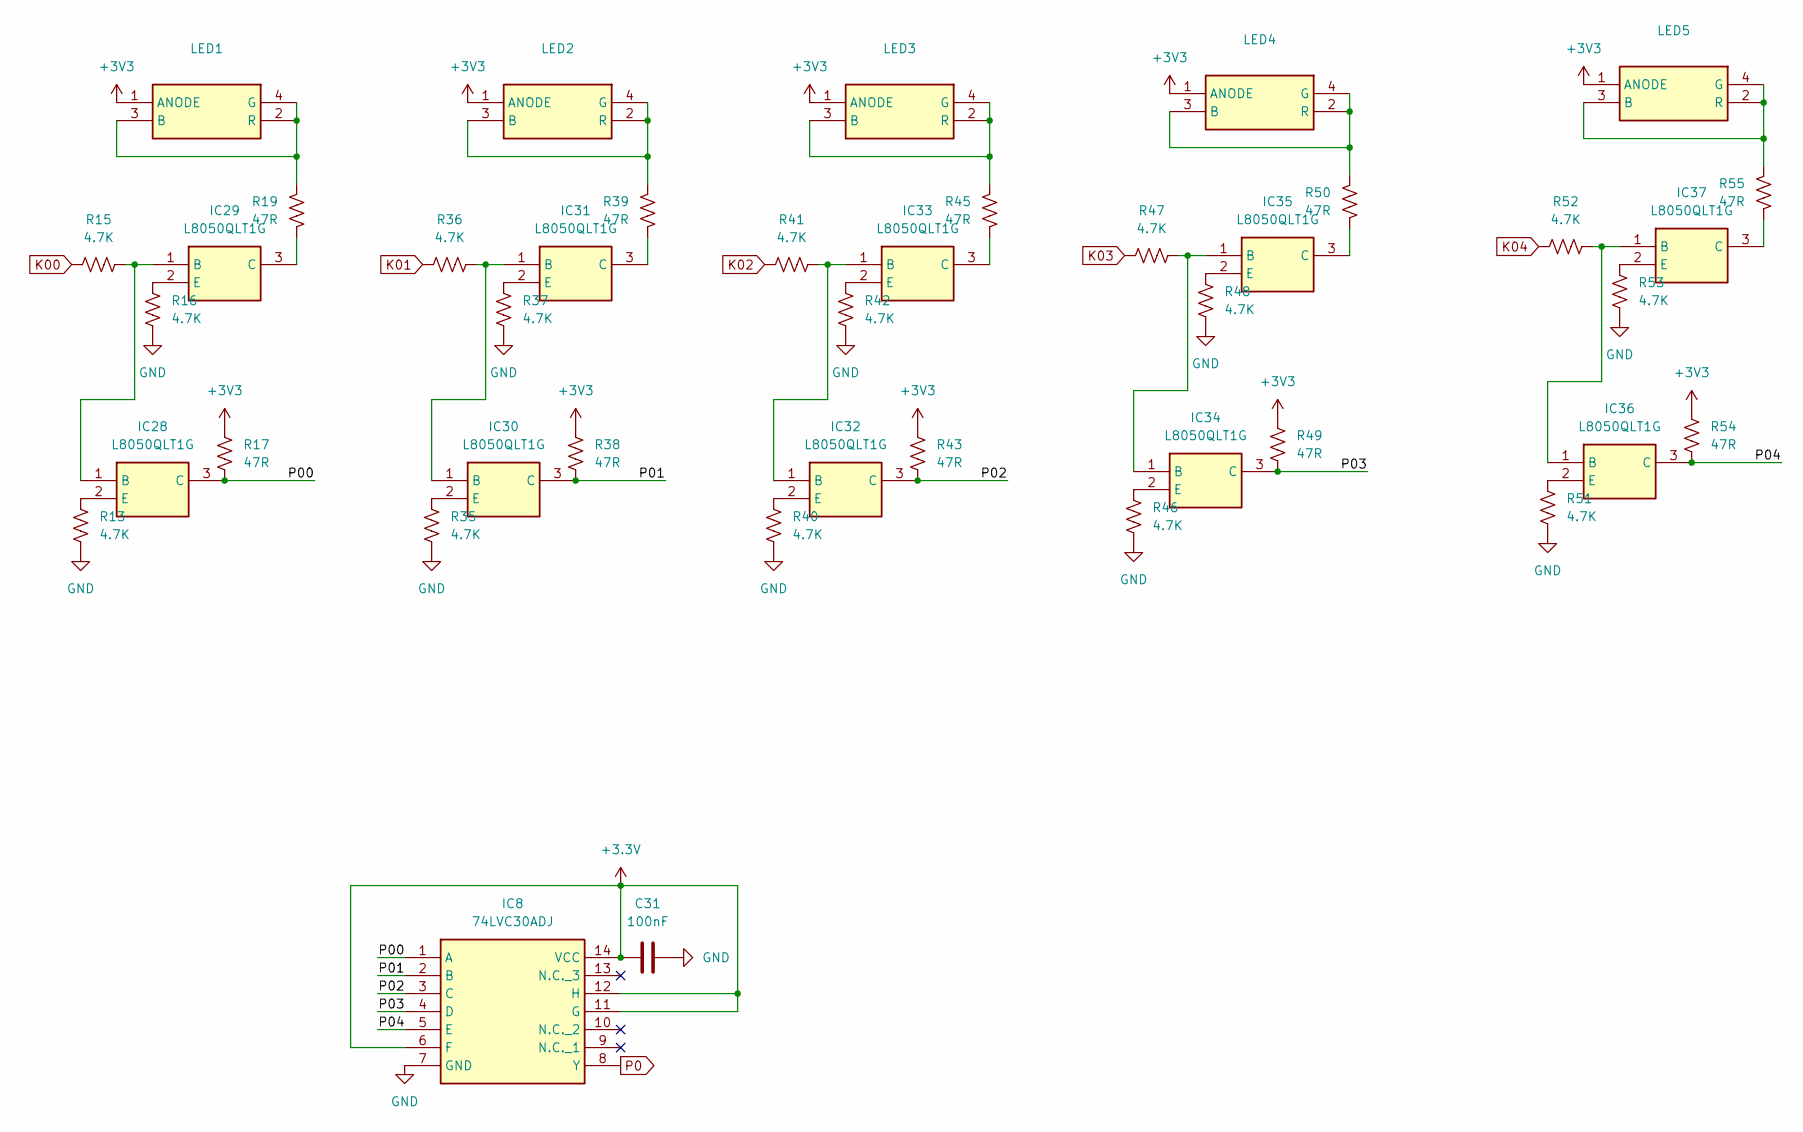
[picture p26: schematic led.kicad_sch]

Parts:
C31: 100nF; C_0603_1608Metric
IC8: 74LVC30ADJ; SOIC127P600X175-14N; Manufacturer_Part_Number 74LVC30ADJ; Mouser Part Number 771-74LVC30ADJ
IC28, IC29, IC30, IC31, IC32, IC33, IC34, IC35, IC36, IC37: L8050QLT1G; Manufacturer_Part_Number L8050QLT1G
LED1, LED2, LED3, LED4, LED5: LTRBR37G-4R4S-0125-0-2-R18; LTRBR37G4R4S012502R18; Manufacturer_Part_Number LTRBR37G-4R4S-0125-0-2-R18; Mouser Part Number 720-LTRBR37GA6714
R13, R15, R16, R35, R36, R37, R40, R41, R42, R46, R47, R48, R51, R52, R53: 4.7K; R_0603_1608Metric
R17, R19, R38, R39, R43, R45, R49, R50, R54, R55: 47R; R_0603_1608Metric

Connections:
+3.3V: C31.1, IC8.6 (F), IC8.11 (G), IC8.12 (H), IC8.14 (VCC); also elsewhere on the board
+3V3: LED1.1 (ANODE), LED2.1 (ANODE), LED3.1 (ANODE), LED4.1 (ANODE), LED5.1 (ANODE), R17.2, R38.2, R43.2, R49.2, R54.2; also elsewhere on the board
/LED1/P00: IC8.1 (A), IC28.3 (C), R17.1
/LED1/P01: IC8.2 (B), IC30.3 (C), R38.1
/LED1/P02: IC8.3 (C), IC32.3 (C), R43.1
/LED1/P03: IC8.4 (D), IC34.3 (C), R49.1
/LED1/P04: IC8.5 (E), IC36.3 (C), R54.1
GND: C31.2, IC8.7 (GND), R13.1, R16.1, R35.1, R37.1, R40.1, R42.1, R46.1, R48.1, R51.1, R53.1; also elsewhere on the board
K00: R15.1; also elsewhere on the board
K01: R36.1; also elsewhere on the board
K02: R41.1; also elsewhere on the board
K03: R47.1; also elsewhere on the board
K04: R52.1; also elsewhere on the board
unnamed: IC28.1 (B), IC29.1 (B), R15.2
unnamed: IC28.2 (E), R13.2
unnamed: IC29.3 (C), R19.1
unnamed: IC29.2 (E), R16.2
unnamed: IC30.1 (B), IC31.1 (B), R36.2
unnamed: IC30.2 (E), R35.2
unnamed: IC31.3 (C), R39.1
unnamed: IC31.2 (E), R37.2
unnamed: IC32.1 (B), IC33.1 (B), R41.2
unnamed: IC32.2 (E), R40.2
unnamed: IC33.3 (C), R45.1
unnamed: IC33.2 (E), R42.2
unnamed: IC34.1 (B), IC35.1 (B), R47.2
unnamed: IC34.2 (E), R46.2
unnamed: IC35.3 (C), R50.1
unnamed: IC35.2 (E), R48.2
unnamed: IC36.1 (B), IC37.1 (B), R52.2
unnamed: IC36.2 (E), R51.2
unnamed: IC37.3 (C), R55.1
unnamed: IC37.2 (E), R53.2
unnamed: LED1.2 (R), LED1.3 (B), LED1.4 (G), R19.2
unnamed: LED2.2 (R), LED2.3 (B), LED2.4 (G), R39.2
unnamed: LED3.2 (R), LED3.3 (B), LED3.4 (G), R45.2
unnamed: LED4.2 (R), LED4.3 (B), LED4.4 (G), R50.2
unnamed: LED5.2 (R), LED5.3 (B), LED5.4 (G), R55.2
P0: IC8.8 (Y); also elsewhere on the board

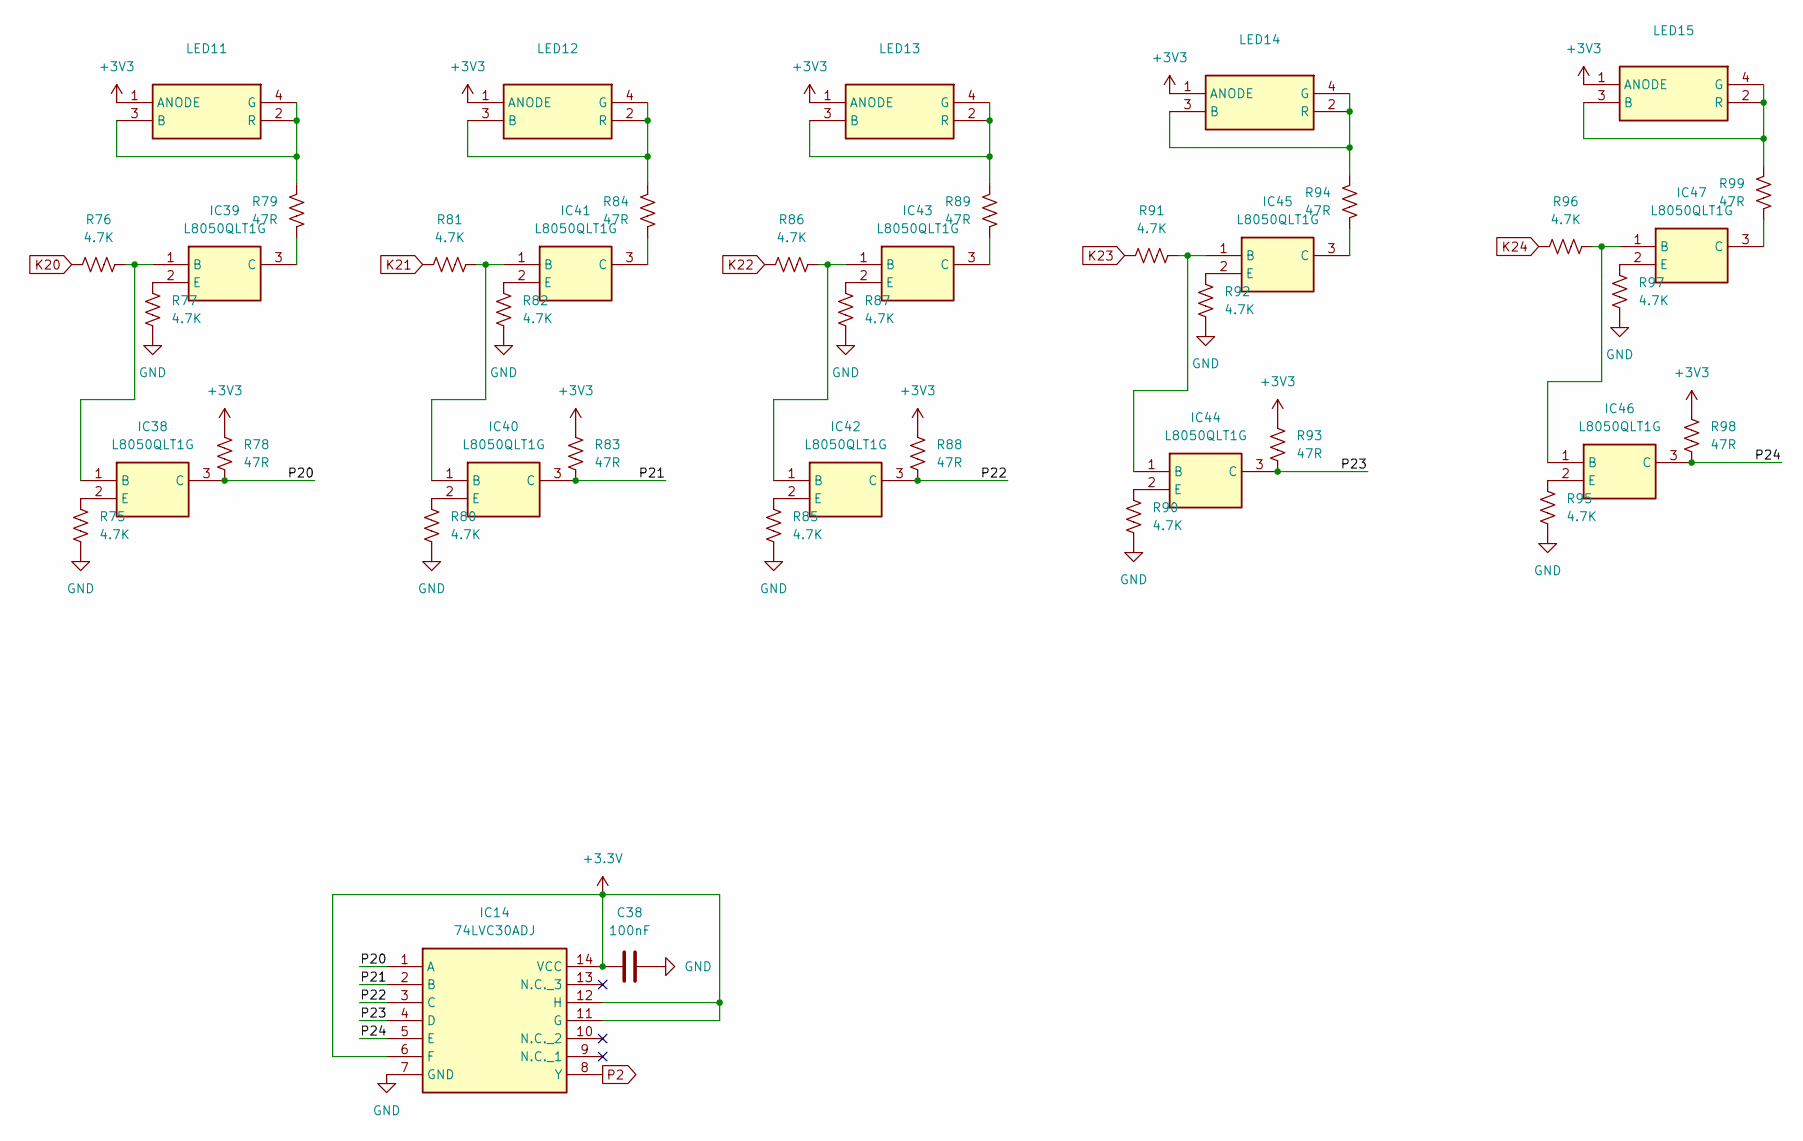
[picture p27: schematic led3.kicad_sch]

Parts:
C38: 100nF; C_0603_1608Metric
IC14: 74LVC30ADJ; SOIC127P600X175-14N; Manufacturer_Part_Number 74LVC30ADJ; Mouser Part Number 771-74LVC30ADJ
IC38, IC39, IC40, IC41, IC42, IC43, IC44, IC45, IC46, IC47: L8050QLT1G; Manufacturer_Part_Number L8050QLT1G
LED11, LED12, LED13, LED14, LED15: LTRBR37G-4R4S-0125-0-2-R18; LTRBR37G4R4S012502R18; Manufacturer_Part_Number LTRBR37G-4R4S-0125-0-2-R18; Mouser Part Number 720-LTRBR37GA6714
R75, R76, R77, R80, R81, R82, R85, R86, R87, R90, R91, R92, R95, R96, R97: 4.7K; R_0603_1608Metric
R78, R79, R83, R84, R88, R89, R93, R94, R98, R99: 47R; R_0603_1608Metric

Connections:
+3.3V: C38.1, IC14.6 (F), IC14.11 (G), IC14.12 (H), IC14.14 (VCC); also elsewhere on the board
+3V3: LED11.1 (ANODE), LED12.1 (ANODE), LED13.1 (ANODE), LED14.1 (ANODE), LED15.1 (ANODE), R78.2, R83.2, R88.2, R93.2, R98.2; also elsewhere on the board
/LED3/P20: IC14.1 (A), IC38.3 (C), R78.1
/LED3/P21: IC14.2 (B), IC40.3 (C), R83.1
/LED3/P22: IC14.3 (C), IC42.3 (C), R88.1
/LED3/P23: IC14.4 (D), IC44.3 (C), R93.1
/LED3/P24: IC14.5 (E), IC46.3 (C), R98.1
GND: C38.2, IC14.7 (GND), R75.1, R77.1, R80.1, R82.1, R85.1, R87.1, R90.1, R92.1, R95.1, R97.1; also elsewhere on the board
K20: R76.1; also elsewhere on the board
K21: R81.1; also elsewhere on the board
K22: R86.1; also elsewhere on the board
K23: R91.1; also elsewhere on the board
K24: R96.1; also elsewhere on the board
unnamed: IC38.1 (B), IC39.1 (B), R76.2
unnamed: IC38.2 (E), R75.2
unnamed: IC39.3 (C), R79.1
unnamed: IC39.2 (E), R77.2
unnamed: IC40.1 (B), IC41.1 (B), R81.2
unnamed: IC40.2 (E), R80.2
unnamed: IC41.3 (C), R84.1
unnamed: IC41.2 (E), R82.2
unnamed: IC42.1 (B), IC43.1 (B), R86.2
unnamed: IC42.2 (E), R85.2
unnamed: IC43.3 (C), R89.1
unnamed: IC43.2 (E), R87.2
unnamed: IC44.1 (B), IC45.1 (B), R91.2
unnamed: IC44.2 (E), R90.2
unnamed: IC45.3 (C), R94.1
unnamed: IC45.2 (E), R92.2
unnamed: IC46.1 (B), IC47.1 (B), R96.2
unnamed: IC46.2 (E), R95.2
unnamed: IC47.3 (C), R99.1
unnamed: IC47.2 (E), R97.2
unnamed: LED11.2 (R), LED11.3 (B), LED11.4 (G), R79.2
unnamed: LED12.2 (R), LED12.3 (B), LED12.4 (G), R84.2
unnamed: LED13.2 (R), LED13.3 (B), LED13.4 (G), R89.2
unnamed: LED14.2 (R), LED14.3 (B), LED14.4 (G), R94.2
unnamed: LED15.2 (R), LED15.3 (B), LED15.4 (G), R99.2
P2: IC14.8 (Y); also elsewhere on the board
