moritzwerkeat/sdr-sch/sdr.kicad_pcb

## KiCad design sdr.kicad_pcb (continued)

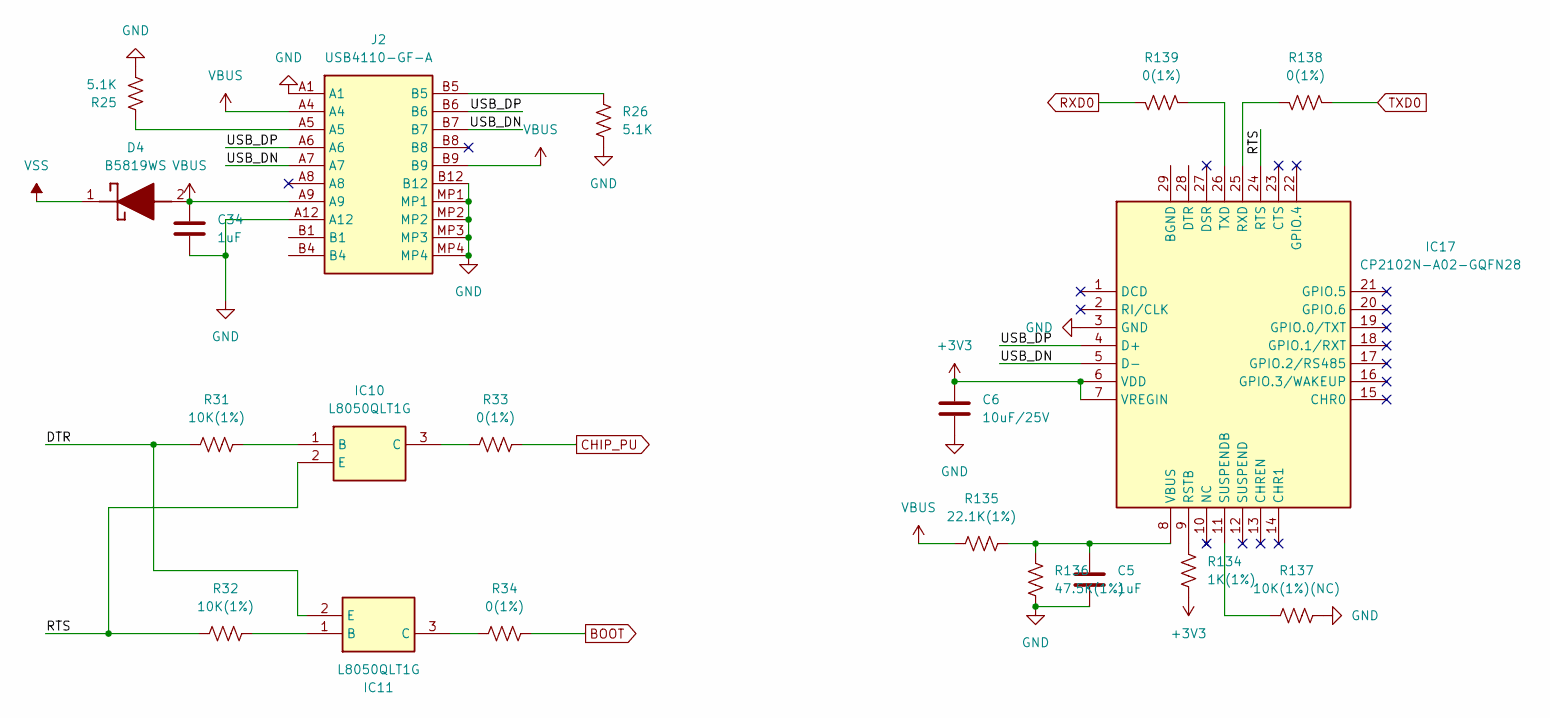
[picture p28: schematic uart.kicad_sch]

Parts:
C5, C34: 1uF; C_0603_1608Metric
C6: 10uF/25V; C_0603_1608Metric
D4: B5819WS; SOD2613X100N; Manufacturer_Part_Number B5819WS
IC10, IC11: L8050QLT1G; Manufacturer_Part_Number L8050QLT1G
IC17: CP2102N-A02-GQFN28; QFN50P500X500X80-29N-D; Manufacturer_Part_Number CP2102N-A02-GQFN28; Mouser Part Number 634-CP2102NA02GQFN28
J2: USB4110-GF-A; USB4110GFA; Manufacturer_Part_Number USB4110-GF-A; Mouser Part Number 640-USB4110-GF-A
R25, R26: 5.1K; R_0603_1608Metric
R31, R32: 10K(1%); R_0603_1608Metric
R33, R34, R138, R139: 0(1%); R_0603_1608Metric
R134: 1K(1%); R_0603_1608Metric
R135: 22.1K(1%); R_0603_1608Metric
R136: 47.5K(1%); R_0603_1608Metric
R137: 10K(1%)(NC); R_0603_1608Metric

Connections:
+3V3: C6.1, IC17.6 (VDD), IC17.7 (VREGIN), R134.1; also elsewhere on the board
/UART/DTR: IC11.2 (E), R31.1
/UART/RTS: IC10.2 (E), IC17.24 (RTS), R32.1
/UART/USB_DN: IC17.5 (D-), J2.A7, J2.B7
/UART/USB_DP: IC17.4 (D+), J2.A6, J2.B6
BOOT: R34.2; also elsewhere on the board
CHIP_PU: R33.2; also elsewhere on the board
GND: C5.2, C6.2, C34.2, IC17.3 (GND), J2.A1, J2.A12, J2.B12, J2.MP1, J2.MP2, J2.MP3, J2.MP4, R25.2, R26.2, R136.2, R137.2; also elsewhere on the board
unnamed: IC10.1 (B), R31.2
unnamed: IC10.3 (C), R33.1
unnamed: IC11.1 (B), R32.2
unnamed: IC11.3 (C), R34.1
unnamed: IC17.9 (RSTB), R134.2
unnamed: IC17.25 (RXD), R138.2
unnamed: IC17.11 (SUSPENDB), R137.1
unnamed: IC17.26 (TXD), R139.1
unnamed: C5.1, IC17.8 (VBUS), R135.2, R136.1
unnamed: J2.A5, R25.1
unnamed: J2.B5, R26.1
RXD0: R139.2; also elsewhere on the board
TXD0: R138.1; also elsewhere on the board
VBUS: C34.1, D4.2 (A), J2.A4, J2.A9, J2.B9, R135.1; also elsewhere on the board
VSS: D4.1 (K); also elsewhere on the board

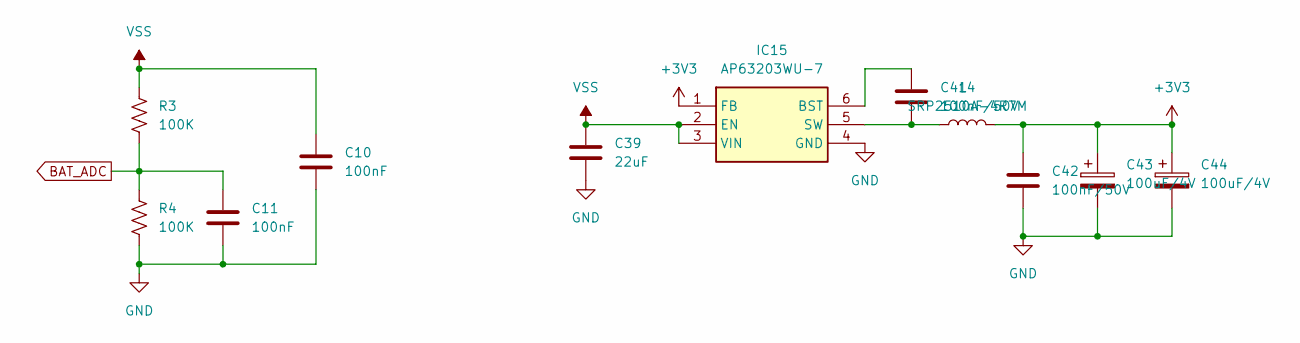
[picture p29: schematic power.kicad_sch]

Parts:
C10, C11: 100nF; C_0603_1608Metric
C39: 22uF; C_0603_1608Metric
C41, C42: 100nF/50V; C_0603_1608Metric
C43, C44: 100uF/4V; CP_EIA-1608-08_AVX-J
IC15: AP63203WU-7; AP63203WU7; Manufacturer_Part_Number AP63203WU-7; Mouser Part Number 621-AP63203WU-7
L4: SRP2510A-4R7M; L_1008_2520Metric
R3, R4: 100K; R_0603_1608Metric

Connections:
+3V3: C42.1, C43.1, C44.1, IC15.1 (FB), L4.2; also elsewhere on the board
BAT_ADC: C11.1, R3.2, R4.1; also elsewhere on the board
GND: C10.2, C11.2, C39.2, C42.2, C43.2, C44.2, IC15.4 (GND), R4.2; also elsewhere on the board
unnamed: C41.1, IC15.6 (BST)
unnamed: C41.2, IC15.5 (SW), L4.1
VSS: C10.1, C39.1, IC15.2 (EN), IC15.3 (VIN), R3.1; also elsewhere on the board

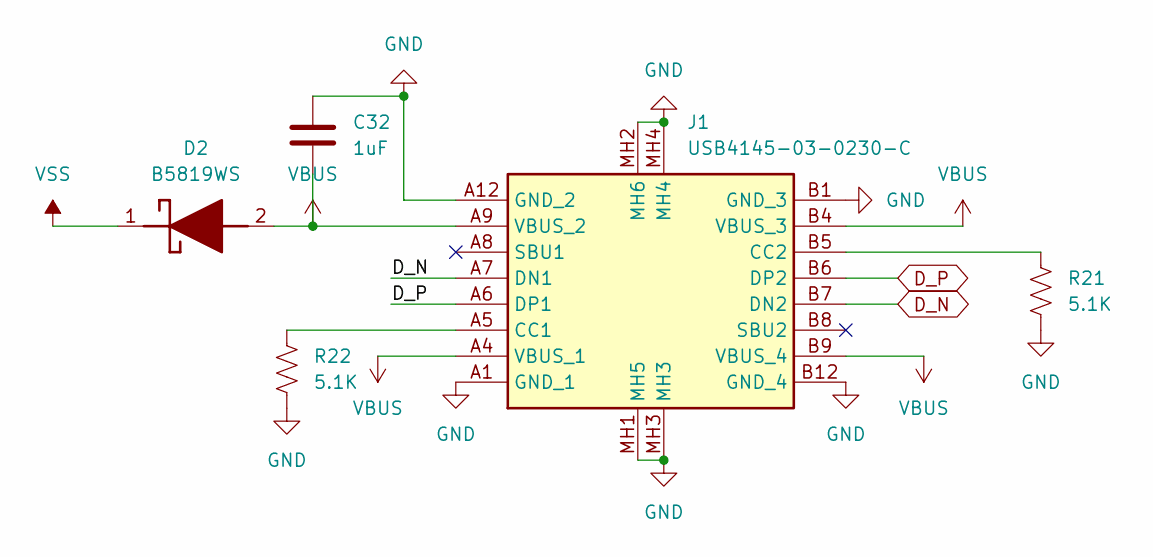
[picture p30: schematic usb.kicad_sch]

Parts:
C32: 1uF; C_0603_1608Metric
D2: B5819WS; SOD2613X100N; Manufacturer_Part_Number B5819WS
J1: USB4145-03-0230-C; USB4145030230C; Manufacturer_Part_Number USB4145-03-0230-C; Mouser Part Number 640-USB4145-3-0230-C
R21: 5.1K; R_0603_1608Metric
R22: 5.1K; C_0603_1608Metric

Connections:
D_N: J1.A7 (DN1), J1.B7 (DN2); also elsewhere on the board
D_P: J1.A6 (DP1), J1.B6 (DP2); also elsewhere on the board
GND: C32.1, J1.A1 (GND_1), J1.A12 (GND_2), J1.B1 (GND_3), J1.B12 (GND_4), J1.MH1 (MH5), J1.MH2 (MH6), J1.MH3, J1.MH4, R21.2, R22.2; also elsewhere on the board
unnamed: J1.A5 (CC1), R22.1
unnamed: J1.B5 (CC2), R21.1
VBUS: C32.2, D2.2 (A), J1.A4 (VBUS_1), J1.A9 (VBUS_2), J1.B4 (VBUS_3), J1.B9 (VBUS_4); also elsewhere on the board
VSS: D2.1 (K); also elsewhere on the board

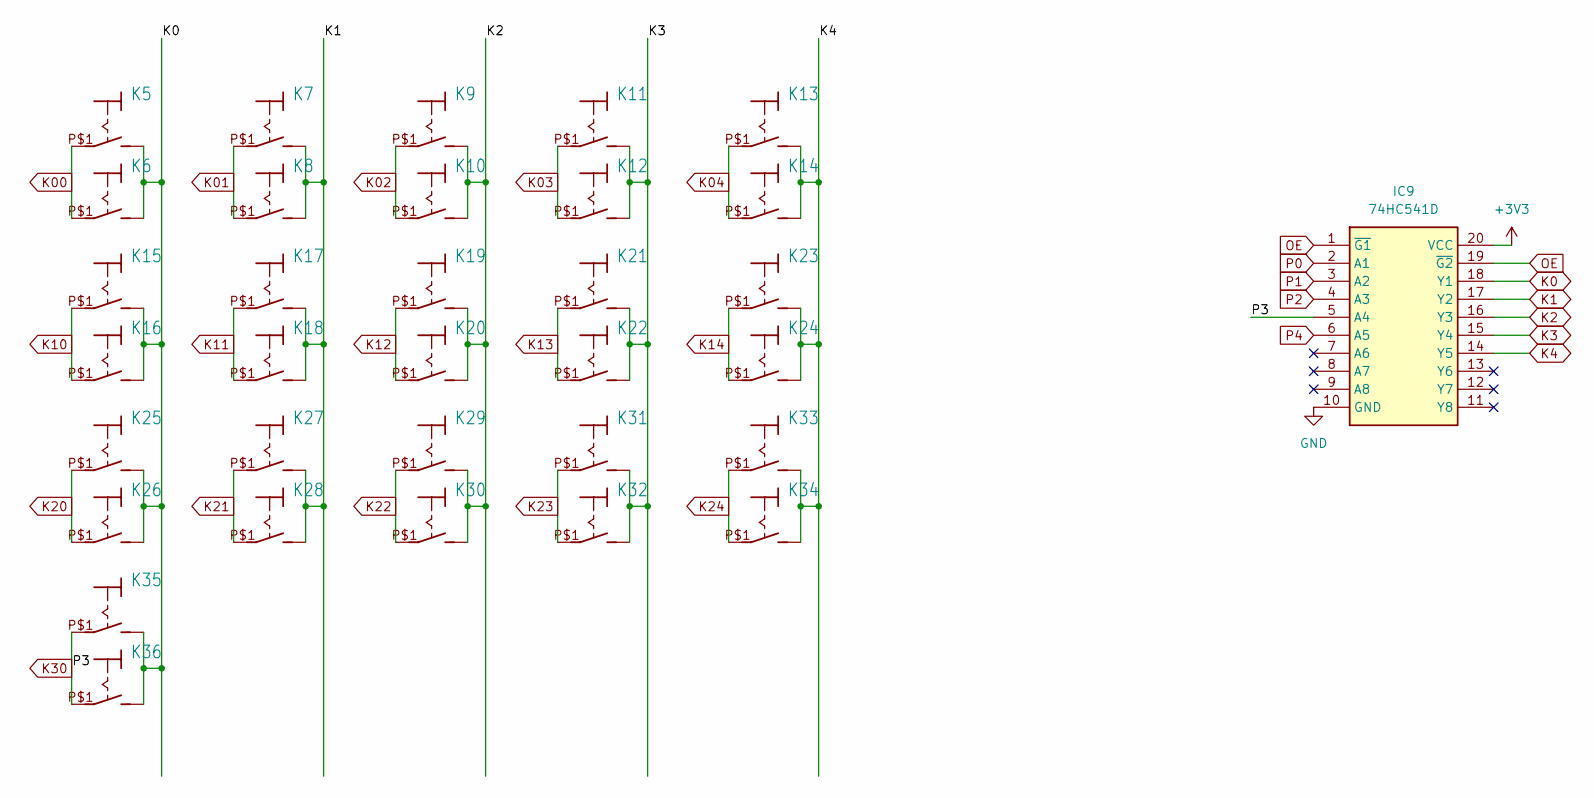
[picture p31: schematic keypad.kicad_sch]

Parts:
IC9: 74HC541D; SOIC127P1030X250-20N; Manufacturer_Part_Number 74HC541D; Mouser Part Number 757-74HC541D
K5, K6, K7, K8, K9, K10, K11, K12, K13, K14, K15, K16, K17, K18, K19, K20, K21, K22, K23, K24, K25, K26, K27, K28, K29, K30, K31, K32, K33, K34, K35, K36: TASTE_GROSS

Connections:
+3V3: IC9.20 (VCC); also elsewhere on the board
GND: IC9.10 (GND); also elsewhere on the board
K0: IC9.18 (Y1), K5.P$2 (S), K5.P$3 (S), K6.P$2 (S), K6.P$3 (S), K15.P$2 (S), K15.P$3 (S), K16.P$2 (S), K16.P$3 (S), K25.P$2 (S), K25.P$3 (S), K26.P$2 (S), K26.P$3 (S), K35.P$2 (S), K35.P$3 (S), K36.P$2 (S), K36.P$3 (S); also elsewhere on the board
K00: K5.P$1, K6.P$1; also elsewhere on the board
K1: IC9.17 (Y2), K7.P$2 (S), K7.P$3 (S), K8.P$2 (S), K8.P$3 (S), K17.P$2 (S), K17.P$3 (S), K18.P$2 (S), K18.P$3 (S), K27.P$2 (S), K27.P$3 (S), K28.P$2 (S), K28.P$3 (S); also elsewhere on the board
K01: K7.P$1, K8.P$1; also elsewhere on the board
K2: IC9.16 (Y3), K9.P$2 (S), K9.P$3 (S), K10.P$2 (S), K10.P$3 (S), K19.P$2 (S), K19.P$3 (S), K20.P$2 (S), K20.P$3 (S), K29.P$2 (S), K29.P$3 (S), K30.P$2 (S), K30.P$3 (S); also elsewhere on the board
K02: K9.P$1, K10.P$1; also elsewhere on the board
K3: IC9.15 (Y4), K11.P$2 (S), K11.P$3 (S), K12.P$2 (S), K12.P$3 (S), K21.P$2 (S), K21.P$3 (S), K22.P$2 (S), K22.P$3 (S), K31.P$2 (S), K31.P$3 (S), K32.P$2 (S), K32.P$3 (S); also elsewhere on the board
K03: K11.P$1, K12.P$1; also elsewhere on the board
K04: K13.P$1, K14.P$1; also elsewhere on the board
K4: IC9.14 (Y5), K13.P$2 (S), K13.P$3 (S), K14.P$2 (S), K14.P$3 (S), K23.P$2 (S), K23.P$3 (S), K24.P$2 (S), K24.P$3 (S), K33.P$2 (S), K33.P$3 (S), K34.P$2 (S), K34.P$3 (S); also elsewhere on the board
K10: K15.P$1, K16.P$1; also elsewhere on the board
K11: K17.P$1, K18.P$1; also elsewhere on the board
K12: K19.P$1, K20.P$1; also elsewhere on the board
K13: K21.P$1, K22.P$1; also elsewhere on the board
K14: K23.P$1, K24.P$1; also elsewhere on the board
K20: K25.P$1, K26.P$1; also elsewhere on the board
K21: K27.P$1, K28.P$1; also elsewhere on the board
K22: K29.P$1, K30.P$1; also elsewhere on the board
K23: K31.P$1, K32.P$1; also elsewhere on the board
K24: K33.P$1, K34.P$1; also elsewhere on the board
OE: IC9.1 (~G1), IC9.19 (~G2); also elsewhere on the board
P0: IC9.2 (A1); also elsewhere on the board
P1: IC9.3 (A2); also elsewhere on the board
P2: IC9.4 (A3); also elsewhere on the board
P4: IC9.6 (A5); also elsewhere on the board

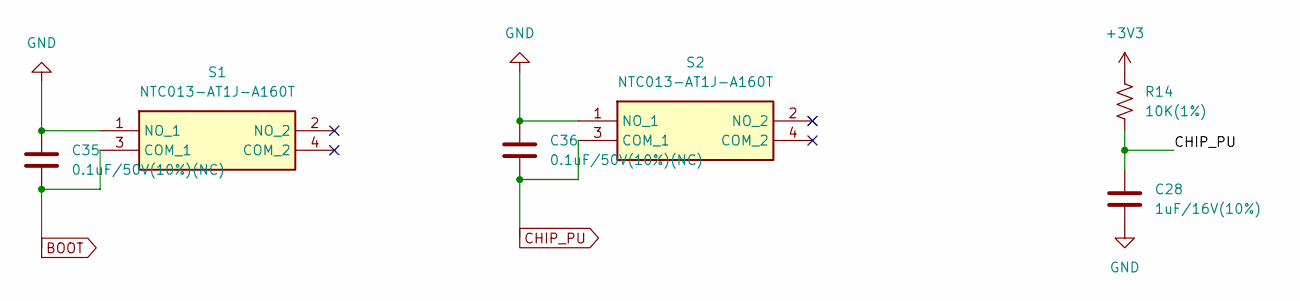
[picture p32: schematic boot.kicad_sch]

Parts:
C28: 1uF/16V(10%); C_0603_1608Metric
C35, C36: 0.1uF/50V(10%)(NC); C_0603_1608Metric
R14: 10K(1%); R_0603_1608Metric
S1, S2: NTC013-AT1J-A160T; NTC013AT1JA160T; Manufacturer_Part_Number NTC013-AT1J-A160T

Connections:
+3V3: R14.1; also elsewhere on the board
BOOT: C35.2, S1.3 (COM_1); also elsewhere on the board
CHIP_PU: C28.1, C36.2, R14.2, S2.3 (COM_1); also elsewhere on the board
GND: C28.2, C35.1, C36.1, S1.1 (NO_1), S2.1 (NO_1); also elsewhere on the board

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
Board: 2 copper layers, 298 parts (0 on the bottom side), 240 nets, no tracks yet.

Other parts of the board:
C37: 100nF; C_0603_1608Metric
IC13: 74LVC30ADJ; SOIC127P600X175-14N
IC18, IC19, IC20, IC21, IC22, IC23, IC24, IC25, IC26, IC27: L8050QLT1G
LED6, LED7, LED8, LED9, LED10: LTRBR37G-4R4S-0125-0-2-R18; LTRBR37G4R4S012502R18
R23, R24, R27, R30, R56, R58, R60, R61, R62, R65, R66, R67, R70, R71, R72: 4.7K; R_0603_1608Metric
R28, R29, R57, R59, R63, R64, R68, R69, R73, R74: 47R; R_0603_1608Metric

Their connections:
+3.3V: C37.1, IC13.6 (F), IC13.11 (G), IC13.12 (H), IC13.14 (VCC); also elsewhere on the board
+3V3: LED6.1 (ANODE), LED7.1 (ANODE), LED8.1 (ANODE), LED9.1 (ANODE), LED10.1 (ANODE), R28.2, R59.2, R63.2, R68.2, R73.2; also elsewhere on the board
/LED2/P10: IC13.1 (A), IC18.3 (C), R59.1
/LED2/P11: IC13.2 (B), IC20.3 (C), R28.1
/LED2/P12: IC13.3 (C), IC22.3 (C), R63.1
/LED2/P13: IC13.4 (D), IC24.3 (C), R68.1
/LED2/P14: IC13.5 (E), IC26.3 (C), R73.1
GND: C37.2, IC13.7 (GND), R23.1, R27.1, R30.1, R58.1, R60.1, R62.1, R65.1, R67.1, R70.1, R72.1; also elsewhere on the board
K10: R56.1; also elsewhere on the board
K11: R24.1; also elsewhere on the board
K12: R61.1; also elsewhere on the board
K13: R66.1; also elsewhere on the board
K14: R71.1; also elsewhere on the board
unnamed: IC18.1 (B), IC19.1 (B), R56.2
unnamed: IC18.2 (E), R60.2
unnamed: IC19.3 (C), R57.1
unnamed: IC19.2 (E), R58.2
unnamed: IC20.1 (B), IC21.1 (B), R24.2
unnamed: IC20.2 (E), R23.2
unnamed: IC21.3 (C), R29.1
unnamed: IC21.2 (E), R27.2
unnamed: IC22.1 (B), IC23.1 (B), R61.2
unnamed: IC22.2 (E), R30.2
unnamed: IC23.3 (C), R64.1
unnamed: IC23.2 (E), R62.2
unnamed: IC24.1 (B), IC25.1 (B), R66.2
unnamed: IC24.2 (E), R65.2
unnamed: IC25.3 (C), R69.1
unnamed: IC25.2 (E), R67.2
unnamed: IC26.1 (B), IC27.1 (B), R71.2
unnamed: IC26.2 (E), R70.2
unnamed: IC27.3 (C), R74.1
unnamed: IC27.2 (E), R72.2
unnamed: LED6.2 (R), LED6.3 (B), LED6.4 (G), R57.2
unnamed: LED7.2 (R), LED7.3 (B), LED7.4 (G), R29.2
unnamed: LED8.2 (R), LED8.3 (B), LED8.4 (G), R64.2
unnamed: LED9.2 (R), LED9.3 (B), LED9.4 (G), R69.2
unnamed: LED10.2 (R), LED10.3 (B), LED10.4 (G), R74.2
P1: IC13.8 (Y); also elsewhere on the board
