moritzwerkeat/sdr-sch/(notices)

Notices in the files:
USB4145-03-0230-C/USB4145-03-0230-C.stp:
author */ ('License CC BY-ND 4.0'),
